L0-0na/Motor_Drive/figures/4 lec.jpg

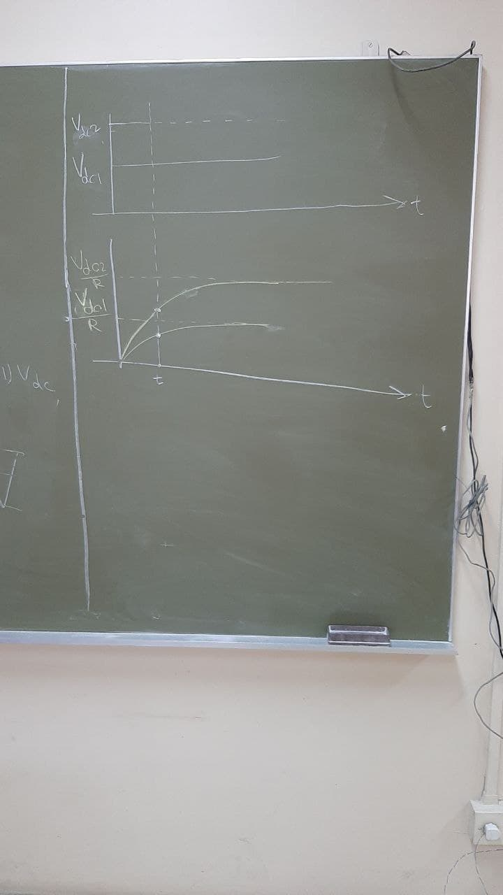
figures/4 lec.jpg
