L0-0na/Motor_Drive/figures/6 lec.jpg

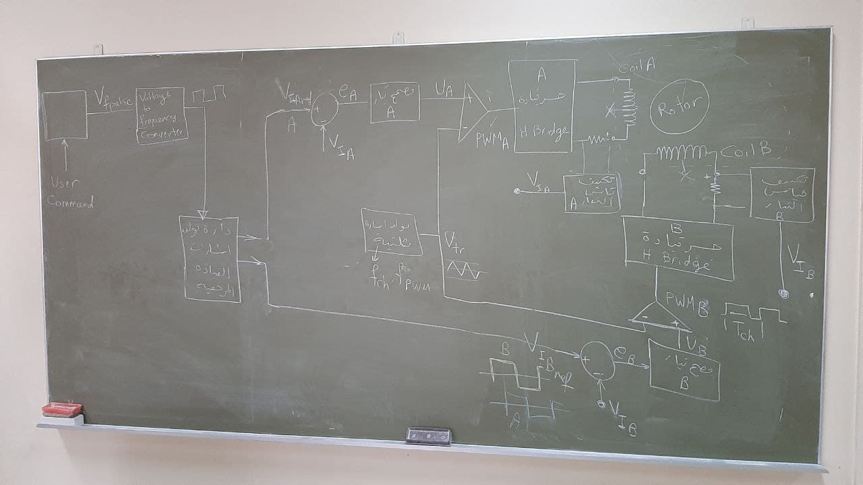
figures/6 lec.jpg
