L0-0na/Motor_Drive/report final.pdf

# اجلمهورية العربية السورية املعهد العايل للعلوم التطبيقية والتكنولوجيا

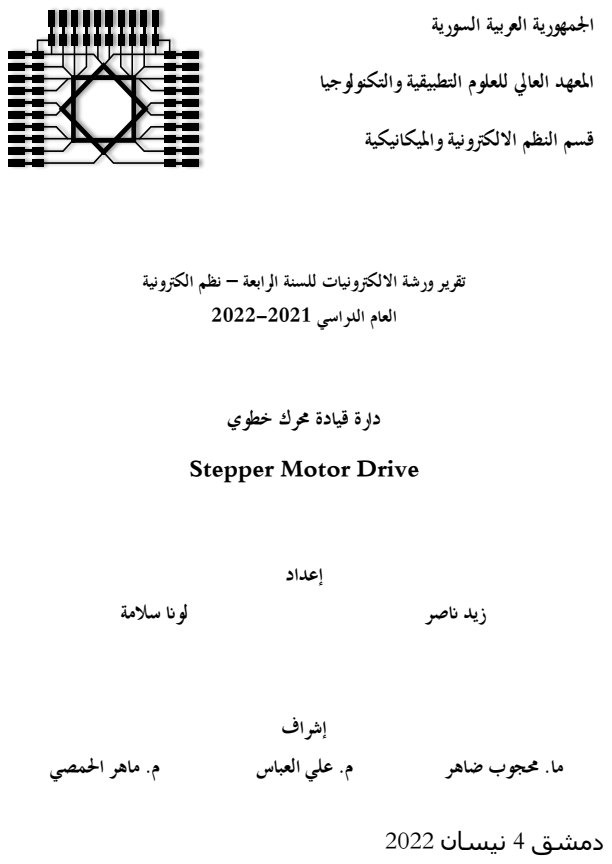
[picture p3: page 1]
إعداد; إشراف; دمشق 4 نيسان 2022

قسم النظم االلكرتونية وامليكانيكية

تقرير ورشة االلكرتونيات للسنة الرابعة – نظم الكرتونية
العام الدراسي 2022-2021

دارة قيادة حمرك خطوي
Stepper Motor Drive

زيد انصر لوان سالمة

ما. حمجوب ضاهر م. علي العباس م. ماهر احلمصي

### المحتويات

ملخص6 |
.1 المحرك الخطوي (Motor Stepper (7 |
.1.1 مكونات المحرك الخطوي7 |
.1.2 أنواع المحرك الخطوي 7 |
.2 طرائق قيادة المحركات الخطوية9 |
.2.1 أحادية القطبية (control Unipolar (9 |
2.1.1. آلية التحكم9 |
.2.1.2 تحليل دارة التحكم11 |
.2.2 ثنائي القطبية control Bipolar15 |
.2.2.1 آلية التحكم15 |
.2.2.2 تحليل الدارة16 |
.3 دفتر الشروط21 |
.4 المخطط الصندوقي 21 |
.5 أجزاء دارة القيادة22 |
.5.1 التغذية السالبة والموجبة22 |
.5.1.1 التغذية السالبة22 |
مضخم pull-push من الصنف AB: 25 |
دارة استعادة DC25 |
دارة مالحقة قمم سالبة26 |
.5.1.2 التغذية الموجبة27 |
.5.2 توليد إشارة القيادة28 |
5.2.1. توليد إشارتي دخل بفرق صفحة 90 )Shifter Phase)28 |
.5.2.2 تعديل مطال إشارة القيادة29 |
.5.2.3 التحكم بجهة الدوران 30 |
32 | Voltage to frequency circuit .5.3
.5.3.1 تحليل الدارة32 |
5.3.2. تعديل عرض ومطال خرج دارة VTF34 |
.5.3.3 تصميم عناصر دارة frequency to Voltage35 |
.5.4 مولد اإلشارة المثلثية )Generator Form Wave)37 |
مبدأ عمل الدارة: 37 |
.5.4.1 تحليل الدارة37 | :
.5.4.2 تصميم الدارة38 |

5.5. توليد إشارات PWM 39 |
.6 تصحيح التيار40 |
6.1. نموذج المحرك: 40 |
6.2. حلقة التحكم41 |
6.2.1. ربح جسر القيادة 41 |
6.2.2. تصميم قائس تيار )Measurements Current)43 |
.6.3 تصميم المصحح PI 46 |
6.3.1. دارة المصحح 46 |
6.3.2. تصميم عناصر دارة المصحح47 |
.7 التطبيق العملي 51 |
.7.1 دارة التغذية السالبة والموجبة51 |
7.2. دارة اإلشارة المثلثية51 |
52 | voltage to frequency | دارة | 7.3.
7.4. إشارتي القيادة المرجعيتين المترابعتين53 |
7.5. الحلقة المفتوحة53 |
.7.6 الحلقة المغلقة: 55 |
الخاتمة56 |
مراجع 57 |

Figure 1 المحرك الخطوي ذو المغناطيس الدائم 7 |
Figure 2 المحرك الخطوي ذو المقاومة المغناطيسية المتغيرة 8 |
Figure 3 المحرك الخطوي الهجين8 |
Figure 4 القيادة بطريقة أحادية القطبية9 |
Figure 5 توضع األقطاب بحالة تفعيل إشارة التحكم 1A9 |
Figure 6 توضع األقطاب بحالة تفعيل إشارة التحكم 1B10 |
Figure 7 توضع األقطاب بحالة تفعيل إشارة التحكم 2A10 |
Figure 8 توضع األقطاب بحالة تفعيل إشارة التحكم 2B11 |
Figure 9 نمذجة دارة التحكم لنصف وشيعة 11 |
Figure 10 نموذج الدارة بحالة تفعيل إشارة التحكم12 |
Figure 11 نموذج الدارة بحالة إلغاء تفعيل إشارة التحكم12 |
Figure 12 التيار المار في الوشيعة14 |
Figure 13 تيار الترانزستور)األحمر(، تيار الديود)األزرق(14 |
Figure 14 القيادة بطريقة ثنائي القطبية 15 |
Figure 15 تسلسل إشارات التحكم16 |
Figure 16 نمذجة دارة التحكم لنصف الوشيعة16 |
Figure 17 نمذجة المرحلة األولى 17 |
18 Figure نمذجة المرحلة الثانية17 |
Figure 19 نمذجة المرحلة الثالثة18 |
Figure 20 نمذجة المرحلة الرابعة19 |
Figure 21 التيار المار في الوشيعة19 |
Figure 22 تيار الديود 3D2,D( األزرق(، تيار الترانزستور9Q8,Q( األخضر(، تيار الديود 4D1,D( األصفر(، تيار
الترانزستور7Q10,Q( األحمر(20 |
Figure 23 الجهد المطبق بين طرفي الوشيعة20 |
Figure 24 المخطط الصندوقي للتغذية السالبة22 |
Figure 25 نمذجة دارة التغذية السالبة 22 |
Figure 26 دارة 555 كقادح مهتز 23 |
Figure 27 جزء شحن وتفريغ المكثفةC 24 |
25 | Push Pull | مضخم | 28 Figure
Figure 29 دارة استعادة DC 25 |
Figure 30 دارة مالحقة قمم 26 |
Figure 31 خرج دارة التغذية السالبة 27 |
32 Figure دارة المنظم 27 |
Figure 33 دارة توليد فرق الطور28 |
34 Figure إشارة الساعة29 |
Figure 35 خرج القالبين29 |
Figure 36 دارة تعديل مطال اإلشارة المرجعية 29 |
Figure 37 نمذجة الجسر مع القالبين ومفتاح تغيير الجهة31 |
Figure 38 اإلشارتين المترابعتين31 |
32 | voltage to frequency | دارة | 39 Figure
34 | voltage to frequency | دارة | خرج | 40 Figure
35 | | التعديل | بعد Voltage to frequency | دارة | 41 Figure

Figure 42 دارة توليد إشارة مثلثية37 |
Figure 43 خرج دارة مولد اإلشارة المثلثية 38 |
Figure 44 مولد إشارة PWM39 |
Figure 45 نموذج المحرك الخطوي 40 |
Figure 46 حلقة التحكم بالتيار 41 |
47 Figure المخطط الصندوقي لPWM41 |
Figure 48 اإلشارة المثلثية واإلشارة المرجعية 42 |
Figure 49 وصل دارة قائس التيار مع الحمل 43 |
Figure 50 دارة قائس التيار 44 |
Figure 51 دارة القائس بعد إضافة الBuffers45 |
Figure 52 تطبيق دارة القائس لقياس تيار الجسر 45 |
Figure 53 دارة المصحح 46 |
Figure 54استجابة النظام بعد التصحيح لدخل خظوي 48 |
Figure 55 مخطط بود للنظام بعد التصحيح 48 |
Figure 56 خرج المصحح )األزرق(, إشارة الدخل )األصفر(, خرج النظام )األحمر( 49 |
Figure 57 خرج المصحح )األزرق(, إشارة الدخل )األصفر(, خرج النظام )األحمر( 49 |
Figure 58 استجابة التيار 50 |
Figure 59 خرج المصحح (command (50 |
Figure 60 إشارتي التغذية السالبة والموجبة51 |
Figure 61 اإلشارة المثلثية51 |
52 | voltage to frequencyال | إشارة | 62 Figure
Figure 63 منحني جهد الدخل بداللة تردد الخرج 52 |
Figure 64 إشارتي القيادة53 |
Figure 65 إشارتي القيادة المحملتان بنبضات PWM53 |
Figure 66 استجابة التيار من أجل تردد 32.4 HZ 54 |
Figure 67 استجابة التيار من أجل تردد 85 HZ54 |

### ملخص

خالل هذا المشروع تم تصميم وتنفيذ دارة قيادة لمحرك خطوي هجين ثنائي الطور Motor Stepper Hybrid من نوع 801BYGH42 لتدوير المحرك بسرعات مختلفة تصل إلى RPM .300 تضمن تصميم الدارة دراسة تقنيات القيادة الخاصة بالمحركات الخطوية واختيار الطريقة األمثل لقيادة المحرك. بداية ً تم قيادة المحرك بالحلقة المفتوحة بتوليد إشارات مرجعية ومقارنتها مع إشارة مثلثية لتعطي نبضات PWM التي تفعل جسر القيادة لنحصل على دوران مستمر للمحرك. ثم تم التحكم باستجابة التيار باستخدام مصحح PI بالحلقة المغلقة لتحقيق دوران مستمر للمحرك من أجل سرعات عالية.

## .1 المحرك الخطوي (Motor Stepper(

المحرك الخطوي هو نظام كهروميكانيكي يقوم بتحويل الطاقة الكهربائية إلى طاقة ميكانيكية عن طريق تدوير محور المحرك. يتميز المحرك الخطوي عن باقي المحركات بأن دورته مقسمة إلى خطوات ويمكن للمحرك أن يستقر على أي خطوة بدون تغذية راجعة في حال استخدامه في التطبيق المناسب )يمكن أن يكون العزم الذي يقدمه المحرك ال يكفي لتدوير المحور وبالتالي يتم احتساب الخطوات ولكن في الحقيقة المحرك ال يدور(.

1 .1. مكونات المحرك الخطوي يوجد عدة أنواع للمحرك الخطوي لكن تشترك جميعها في هذه األجزاء:

-1 الدائر )Rotor): هو الجزء الذي يدور من المحرك وعليه يُثبت محور المحرك الذي يحمل األحمال الميكانيكية. -2 الثابت )Stator): هو الجزء الثابت من المحرك ويحتوي الوشائع واألسالك التي يتم تغذية المحرك من خاللها. عدد الوشائع المستخدمة في الثابت يتبع لنوع التطبيق )أحادي الطور, ثنائي الطور, ثالثي الطور(.

2 .1. أنواع المحرك الخطوي
تصنف المحركات الخطوية من ناحية طريقة التصنيع إلى ثالث مكونات أساسية:

-1 المحرك الخطوي ذو المغناطيس الدائم )Magnet Permanent The(: في هذذا النوع من المحركذات يكون الذدائر عبذارة عن مغنذاطيس دائم بينمذا يتكون الثذابذت من مذادة فيرو مغنذاطي سذيذة تتوضذع ضذمنها نواقل. ينتا الدوران عن طريق تفاعل الحقل المغناطيسذي الدائم للدائر مع الحقل المغناطيسذي المتولد من تغذية نواقل الثابت.
يتميز هذا النوع من المحركات بعزم دوران كبير مقارنة بالمحركات ذو المقاومة المغناطيسية المتغيرة ولكن هذا النوع من المحركات محدود من حيث عدد الخطوات الممكنة في الدورة.

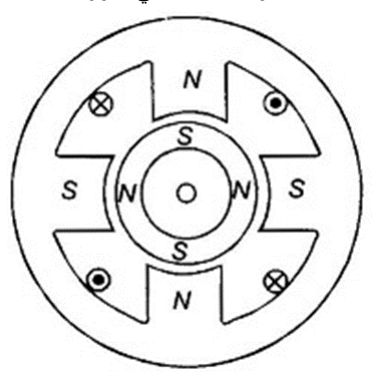
[picture p4: figure]

Figure 1 المحرك الخطوي ذو المغناطيس الدائم

-2 المحرك الخطوي ذو المقاومة المغناطيسية المتغيرة )Reluctance Variable The(: يتكون الدائر من مادة فيرو مغناطيسية مصممة على شكل أسنان. يتكون الثابت من مادة فيرو مغناطيسية أيضاً مصممة على شكل أسنان على السطح الداخلي ويتم لف الوشائع حول أسنان الثابت. ينتا دوران المحرك من توضع الدائر بحيث تكون المقاومة المغناطيسية لتدفق حقل الثابت المغناطيسي عبره أقل ما يمكن بالتالي بتفعيل وشائع الثابت بتسلسل معين نحصل على دوران مستمر.

يتميز هذا النوع من المحركات بخطوة صغيرة ودقيقة لكن عزم الدوران صغير مقارنة بباقي األنواع لكونه يعتمد على حقل مغناطيسي وحيد )حقل الثابت(.

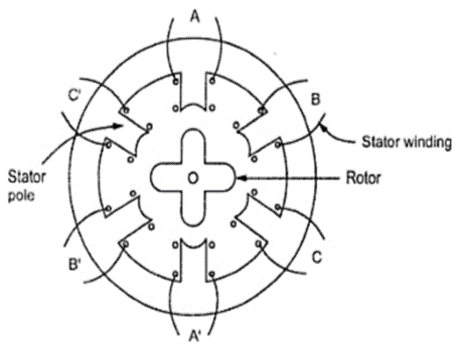
[picture p5: figure]

Figure 2 المحرك الخطوي ذو المقاومة المغناطيسية المتغيرة

-3 المحرك الخطوي الهجين (Hybrid The(: هذا النوع من المحركات يعتمد على مبدأ عمل كل من المحركات ذو المغناطيس الدائم والمحركات ذو المقاومة المغناطيسية المتغيرة للحصول على عزم كبير باإلضافة لخطوة صغيرة ودقيقة. في هذا النوع من المحركات يكون الدائر عبارة عن مغناطيس دائم أسطواني يتوضع ضمن أسطوانة مسننة. يتكون الثابت من مادة فيرو مغناطيسية أيضاً مصممة على شكل أسنان على السطح الداخلي. عند تغذية وشائع الثابت ينتا أقطاب مغناطيسية وكون الثابت عبارة عن مغناطيس دائم بالتالي تتوضع كل من أسنان الثابت والدائر بحيث تحقق أقل مقاومة مغناطيسية بين األقطاب المتعاكسة وأكبر مقاومة مغناطيسية بين األقطاب المتشابهة.

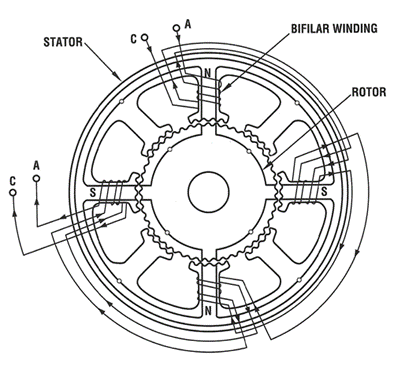
[picture p6: figure]

Figure 3 المحرك الخطوي الهجين

كما يتم تصنيف المحركات الخطوية تبعاً لكيفية إتاحة أطراف النواقل للمستخدم إلى:

-1 ثنائية القطبية (Bipolar(: يُتاح للمستخدم طرفي كل ناقل. -2 أحادي القطبية (Unipolar(: يتاح للمستخدم طرفي كل ناقل باإلضافة لنقطة الوسط.

### .2 طرائق قيادة المحركات الخطوية

المحرك الذي تم استخدامه في دراستنا من نوع Moto Stepper Hybrid Unipolar ثنائي الطور بالتالي يمكن التحكم به إما كأحادي قطبية أو كثنائي قطبية.

1 .2. أحادية القطبية (control Unipolar( 1 1. .2. آلية التحكم

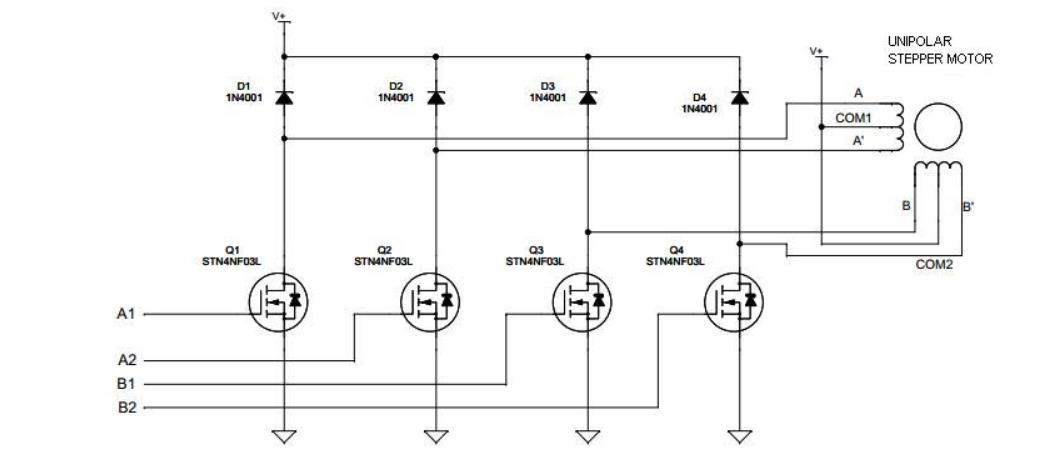
[picture p7: figure]

Figure 4 القيادة بطريقة أحادية القطبية

′ | يتم وصل نقطة المنتصف لكل من الوشيعتين إلى + ووصل النقاط ,
′ , , إلى األرضي مع قواطع هي
الترانزستورات 4 3,2,1, على الترتيب. وتم إضافة كل من الديودات 43, 2,1, كدوالب حر في حال تم فتح القاطعة ولم ينعدم تيار الوشيعة بعد.

لنفترض أنه في البداية تم تفعيل إشارة التحكم 1 عندها سيمر التيار من 1COM إلى مولداً حقال مغناطيسياً كما في الشكل:

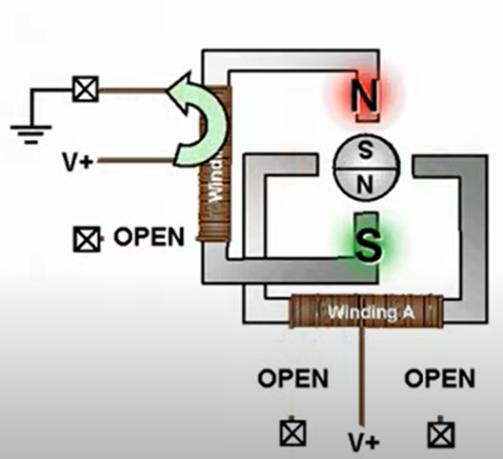
[picture p8: figure]

Figure 5 توضع األقطاب بحالة تفعيل إشارة التحكم 1A

نتيجة لهذا الحقل يدور الدائر لوضع االستقرار الذي يفرضه حقل الثابت.

ثم يتم إلغاء تفعيل إشارة التحكم 1 وتفعيل إِشارة التحكم 1 عندها يمر التيار من 2COM إلى مولداً حقال مغناطيسياً كما في الشكل:

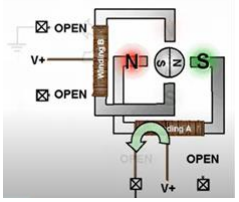
[picture p9: figure]

Figure 6 توضع األقطاب بحالة تفعيل إشارة التحكم 1B

| نتيجة للحقل الجديد للثابت يدور الدائر 90
عكس عقارب الساعة.

بنفس الطريقة يتم إلغاء تفعيل إشارة التحكم 1 وتفعيل إشارة التحكم 2 ليتولد حقل مغناطيسي ناتا عن مرور
| التيار من 1COM إلى ′ مسبباً دوران المحرك 90
أخرى عكس عقارب الساعة.

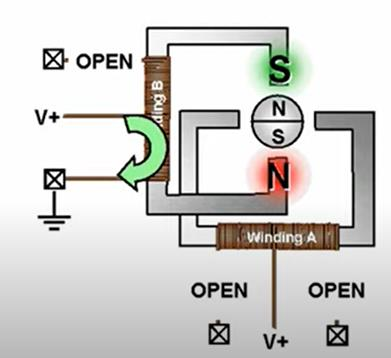
[picture p10: figure]

Figure 7 توضع األقطاب بحالة تفعيل إشارة التحكم 2A

أخيراً بإلغاء تفعيل إِشارة التحكم 2 وتفعيل إِشارة التحكم 2 ليتولد حقل مغناطيسي ناتا عن مرور التيار من
| 2COM إلى ′ مسبباً دوران المحرك 90
أخرى عكس عقارب الساعة.

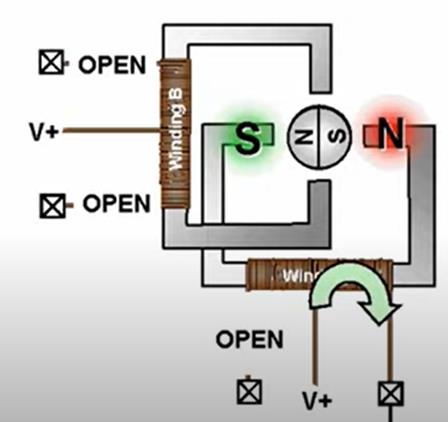
[picture p11: figure]

Figure 8 توضع األقطاب بحالة تفعيل إشارة التحكم 2B

بالتالي بترتيب تفعيل إشارات التحكم بالشكل الصحيح نضمن دوران مستمر للمحرك حيث يتم عند كل تغيير إلشارة التحكم تغيير الحقل المغناطيسي للثابت ويقوم الدائر بمالحقته وبذلك نحصل على دوران المحرك.

لتغيير جهة دوران المحرك علينا فقط أن نقوم بتغيير تسلسل إشارات التحكم:

دوران عكس عقارب الساعة ... 1, 2, 2, 1, 1,

دوران مع عقارب الساعة ... 1, 1, 2, 2, 1,

ليس من الضروري أن نبدأ دائما من 1 حيث نستطيع أن نبدأ من أي إشارة تحكم ضمن السلسلة بشرط أن نكمل السلسلة بدءاً من اإلشارة المختارة مثالً كل من السالسل التالية تؤمن دوران مع عقارب الساعة:

B1, A2, B2, A1, B1, …

A2, B2, A1, B1, A2, …

B2, A1, B1, A2, B2, …

2 1. .2. تحليل دارة التحكم

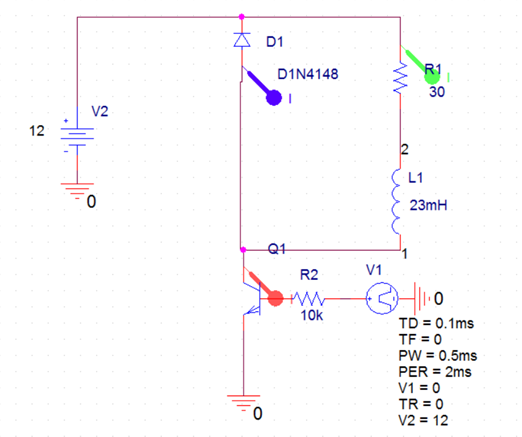
[picture p12: figure]

Figure 9 نمذجة دارة التحكم لنصف وشيعة

تم العمل على محرك مقاومة ملفات الثابت له Ω 30 = 1 Rوذاتية ملفاته mH 23 = 1L. وتم نمذجة إشارة التحكم بمولد نبضات مربعة.

خالل فترة تطبيق إشارة تحكم يكون الترانزستور الموافق لإلِشارة المفعلة في النمط ON والديود الموافق لهذه اإلشارة في النمط OFF بالتالي تكون الدارة المكافئة:

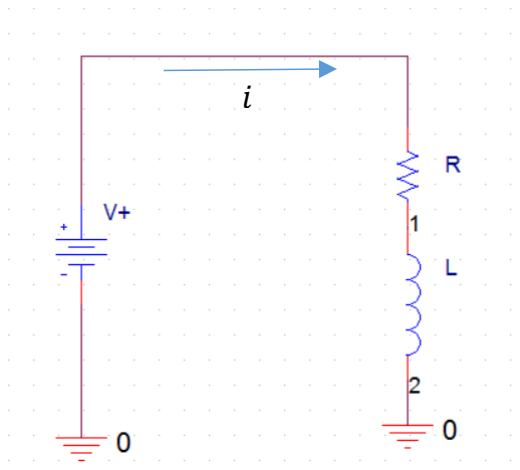
[picture p13: figure]

Figure 10 نموذج الدارة بحالة تفعيل إشارة التحكم

V+ = R. i + L

di
dt , i(0) = i0

⇒ i(t) =

V+
R

(1 − exp (−

R
L
| .t)) + i0 exp (−

R
L

.t)

| يستمر تطبيق إِشارة التحكم لفترة زمنية
4

i (

T
4

) =

V+
R

(1 − exp (−

R
L

T
4

)) + i0 exp (−

R
L

T
4

)

بعد االنتهاء زمن تفعيل إِشارة التحكم يصبح الترانزستور الموافق لإلِشارة المفعلة في النمط OFF والديود الموافق لهذه اإلشارة في النمط ON بالتالي تكون الدارة المكافئة:

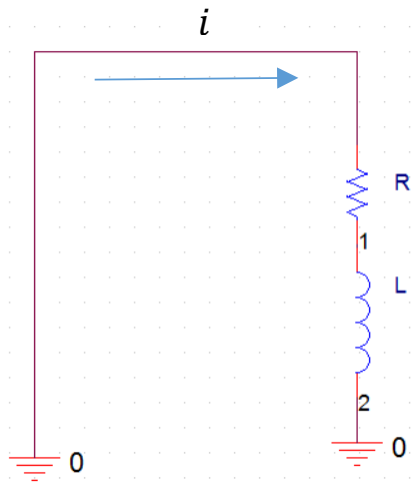
[picture p14: figure]

Figure 11 نموذج الدارة بحالة إلغاء تفعيل إشارة التحكم

0 = R. i + L

di
dt
ومن استمرارية التيار المار في الوشيعة:

i (

T
4

) =

V+
R

(1 − exp (−

R
L

T
4

)) + i0 exp (−

R
L

T
4

)

بالتالي:

i(t) = (

V+
R

(1 − exp (−

R
L

T
4

)) + i0 exp (−

R
L

T
4

)) exp (−
R
L

. (t −

T
4

))

يبقى الديود في الوضع ON حتى ينعدم تياره عند اللحظة وعندها يعود الترانزستور للوضع ON حيث تم تطبيق إِشارة التحكم من جديد.

ومن استمرارية التيار المار في الوشيعة:

i(T) = i0
(

V+
R

(1 − exp (−

R
L

T
4

)) + i0 exp (−

R
L

T
4

)) exp (−

R
L

3T
4

) = i0

i0 =

V+
R

1 − exp (−

RT
4L

)

exp (

3RT
4L

) − exp (−

RT
4L

)

بالتالي تصبح معادلة التيار المار في الوشيعة:

i(t) =

V+
R

(1 − exp (−
R
L

.t)

exp (

3RT
4L

) − 1

exp (

3RT
4L

) − exp (−

RT
4L

)

) ,t <
T
4

i(t) =

V+
R

(
exp (

RT
L

) − exp (−

3RT
4L

)

exp (

RT
L

) − 1

)exp (−
R
L

. (t −

T
4

)) ,
T
4

< t < T

التطبيق العددي: m 2 = , m 23 = , Ω 30 R = , volt12 = +V

i0 | imax
| | m 206.87 m 29.2 نظرياً
| | m 209.99 m 10 المحاكاة

يعود الفرق بين قيم المحاكاة والقيم النظرية إلهمال هبوط الجهد على كل من الديود والترانزستور خالل الدراسة النظرية.

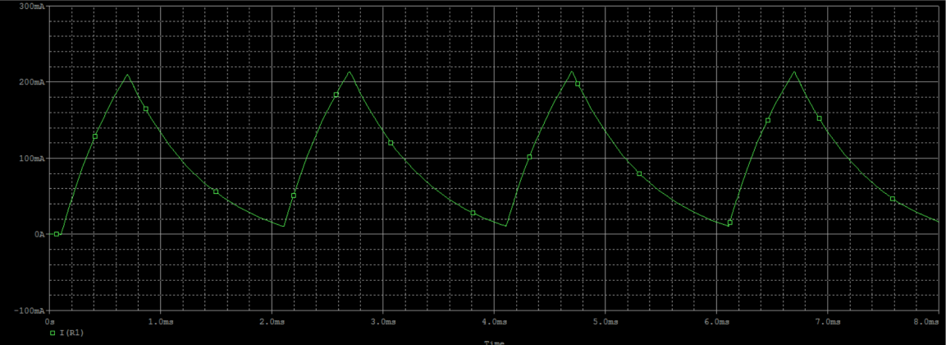
[picture p15: figure]

Figure 12 التيار المار في الوشيعة

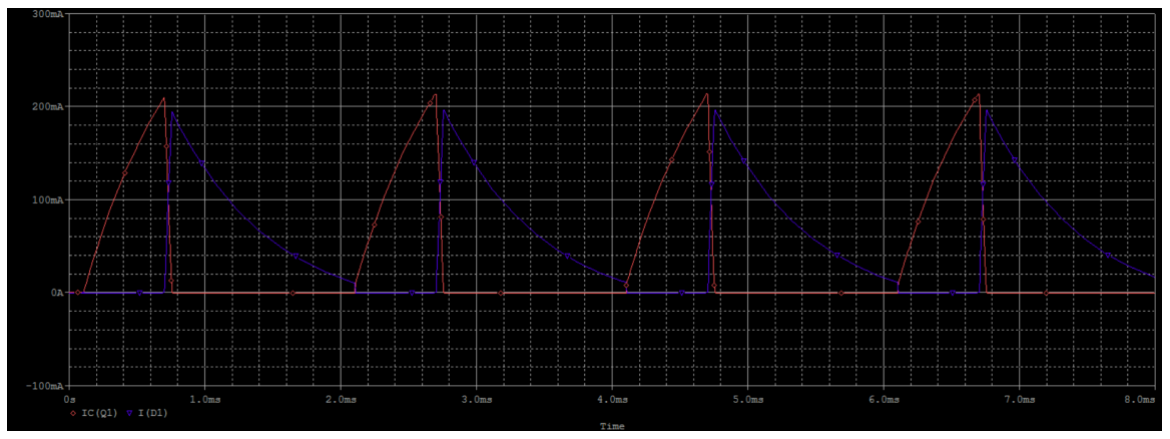
[picture p16: figure]

Figure 13 تيار الترانزستور)األحمر(، تيار الديود)األزرق(

- مساوئ هذه الطريقة:
ال يتم استخدام كل اإلمكانيات المتاحة )فقط نصف ملف يعمل خالل لحظة معينة( أي يتم استهالك ربع كمية النحاس المستخدمة للف الوشائع.

2 .2. ثنائي القطبية control Bipolar في هذا النوع من التحكم ال يتم استخدام نقطة الوسط بالتالي ال يوجد طريقة مباشرة لعكس جهة التيار المار في الوشائع لذلك يتم استخدام جسر H كمفعل للمحرك وهذا ما يمكننا من عكس جهة التيار.

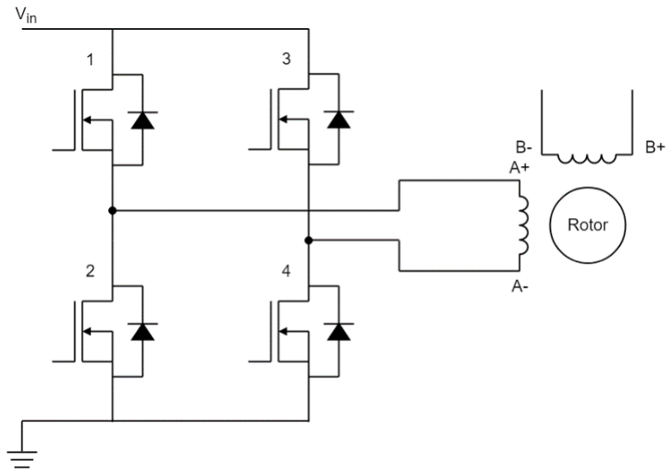
[picture p17: figure]

Figure 14 القيادة بطريقة ثنائي القطبية
1 2. .2. آلية التحكم
يوجد عدة طرق لقيادة المحرك باستخدام جسر H منها

-1 طور واحد فقط يعمل في كل لحظة: أوالً يتم تفعيل إشارات التحكم 1 و4 للوشيعة ثم يتم تفعيل إِشارات التحكم 1 و4 للوشيعة وإلغاء تفعيل إشارات التحكم السابقة. يليها تفعيل إشارات التحكم 3 و2 للوشيعة وإلغاء تفعيل إشارات التحكم السابقة. ثم تفعيل إشارات التحكم 3 و2 للوشيعة وإلغاء تفعيل إشارات التحكم السابقة. ال تعطي هذه الطريقة عزم كبير ألنه يتم تفعيل وشيعة واحدة في كل نصف دور.

-2 طوران يعمالن في كل لحظة: أوالً يتم تفعيل إِشارات التحكم 1 و4 لكل من و معاً عندها يتشكل حقل مغناطيسي ناتا عن مجموع كل من الحقلين الناتجين عن الوشيعة والوشيعة ويدور الدائر إلى موضع التوازن الذي يحدده الحقل المغناطيسي الناتا من الثابت. يتم بعدها تفعيل إشارات التحكم 3 و2 للوشيعة وإلغاء 1و4 بنفس الوقت نبقي على إشارات التحكم السابقة للوشيعة فيدور إلى موضع التوازن الجديد. ثالثاً يتم تفعيل إشارات التحكم 3 و2 للوشيعة ونبقي على إشارات التحكم السابقة للوشيعة . أخيراً يتم تفعيل إشارات التحكم 1 و4 للوشيعة ونبقي على إشارات التحكم السابقة للوشيعة .

بالتالي نستطيع قيادة المحرك بتطبيق إشارتي التحكم , ، عندما تكون بالمستوى المرتفع يتم تفعيل الترانزستورين 1و4 للجسر األول وعندما تكون بالمستوى المنخفض يتم تفعيل الترانزستورين 2و،3 كذلك األمر بالنسبة لإلشارة والجسر الثاني.

لتحقيق ما سبق يجب أن تكون إشارة التحكم على ترابع مع .

نحصل في هذه الطريقة على عزم أكبر من الطريقة السابقة ونفس عدد الخطوات.

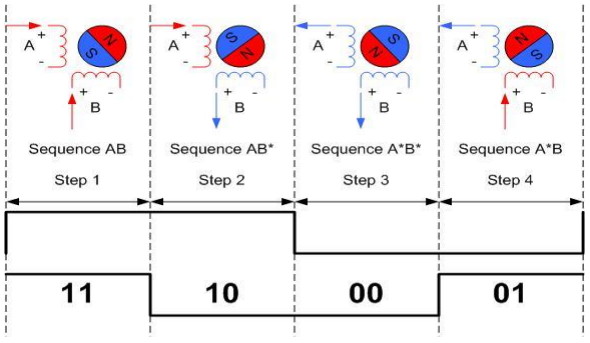
[picture p18: figure]

Figure 15 تسلسل إشارات التحكم

سيتم استخدام طريقة ثنائية القطبية بما أنها تؤمن عزم أكبر بنفس عدد الخطوات.

2 2. .2. تحليل الدارة

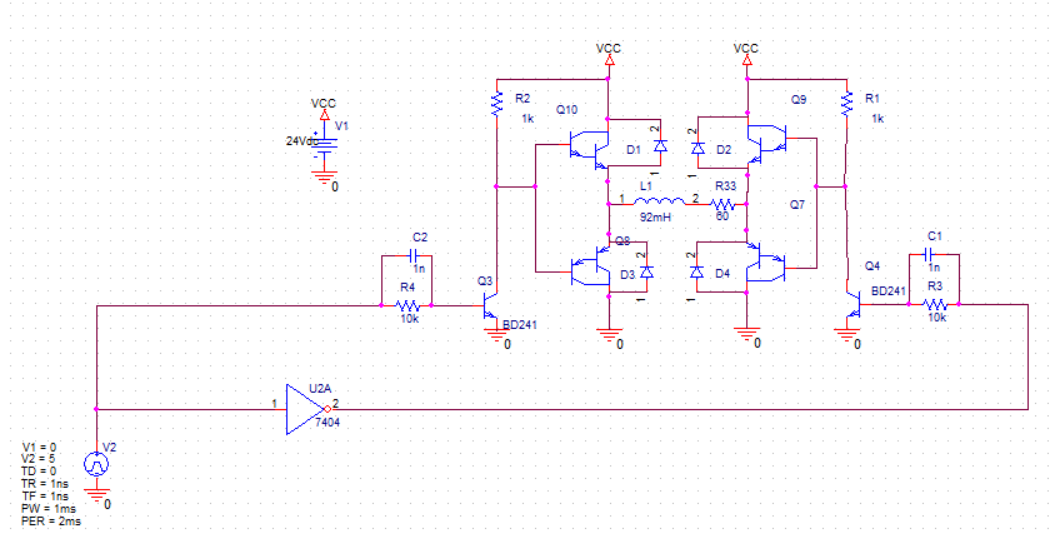
[picture p19: figure]

يعمل الترانزستورين 43, مع المقاومتين 3 4, على رفع مطال إشارة التحكم من volt 5 إلى volt 24 فعند تطبيق إشارة التحكم volt 5 على قاعدة الترانزستور 3 يصبح في النمط ON وبالتالي يصبح جهد قاعدة كل من الترانزستورين 8 10, volt 0 وعند تطبيق إشارة التحكم volt 0 على قاعدة الترانزستور 3 يصبح في النمط OFF وبالتالي يصبح جهد قاعدة كل من الترانزستورين 8 10, volt 24 تقريبا.ً وكذلك األمر بالنسبة لكل من الترانزستورين 79,.

يتم اختيار 3 4, بحيث يكون التيار المسحوب من المنبع عبرهما كافياً إلدخال الترانزستورين 43, باإلشباع.

Figure 16 نمذجة دارة التحكم لوشيعة

تم استخدام المكثفتين 2 1, لتأمين إغالق سريع للترانزستورين 43, وبدوره فتح وإغالق سريع للترانزستورات 10 9,8,7,.

أما بالنسبة الختيار تشكيلة دارلنغتون للترانزستورات 10 9,8,7, فذلك لتأمين مرتفعة وبالتالي تيار قاعدة منخفض بحكم أن تيار المجمع يتم تحديده من قبل الحمل. وكلما كان تيار القاعدة منخفض أكثر يكون جهد القاعدة أقرب إلى القيمة المطلوبة والتي هي volt .24

مراحل عمل الدارة
المرحلة األولى: عندما تكون الديودات 41, في النمط ON:

Figure 17 نمذجة المرحلة األولى

−VCC = L

di
dt + Ri , i(0) = i0

i(t) =

−VCC
R

(1 − exp (−

R
L

.t)) + i0 exp (−

R
L

.t)

يبقى الديودان 41, في النمط ON حتى ينعدم التيار عند اللحظة 1:

i(t1

) = 0 =

−VCC
R

(1 − exp (−

R
L

.t1)) + i0 exp (−

R
L

.t1)

t1 =

L
R

ln(

Ri0 + VCC

VCC

)

المرحلة الثانية: عندما يكون 7 10, في النمط ON والديودات 41, في النمط OFF:

نمذجة المرحلة الثانية18 Figure

VCC = L

di
dt + Ri , i(t1

) = 0

i

i

i(t) =

VCC
R

(1 − exp (−

R
L

. (t − t1)))

تستمر هذه المرحلة من اللحظة 1 حتى اللحظة α:

i(αT) =

VCC
R

(1 − exp (−

R
L

. (αT − t1)))

المرحلة الثالثة: عندما تكون الديودات 32, في النمط ON:

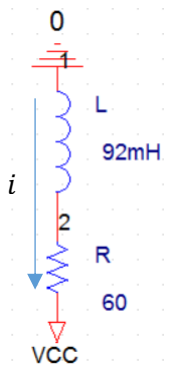
[picture p20: figure]

Figure 19 نمذجة المرحلة الثالثة

−VCC = L

di
dt + Ri , i(αT) =

VCC
R

(1 − exp (−

R
L

. (αT − t1

)))

i(t) =

−VCC
R

(1 − exp (−

R
L

. (t − αT))) + i(αT) exp (−

R
L

. (t − αT))

يبقى الديودان 32, في النمط ON حتى ينعدم التيار عند اللحظة 2:

i(t2

) = 0 =

−VCC
R

(1 − exp (−

R
L

. (t2 − αT))) + i(αT) exp (−

R
L

. (t − αT))

t2 =

L
R

ln(

Ri(αT) + VCC

VCC

) + αT

المرحلة الرابعة: عندما يكون 89, في النمط ON والديودات 32, في النمط OFF:

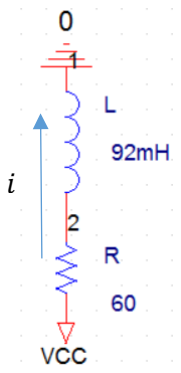
[picture p21: figure]

Figure 20 نمذجة المرحلة الرابعة

VCC = L

di
dt + Ri , i(t2

) = 0

i(t) =

VCC
R

(1 − exp (−

R
L

. (t − t2)))

تستمر هذه المرحلة من اللحظة 2 حتى اللحظة :

i(T) =

VCC
R

(1 − exp (−

R
L

. (T − t2)))

من استمرار تيار الوشيعة نحصل على قيمة 0:

i0 = i(T)

التطبيق العددي: 0.5 = ,m 2 = , m 92 = , Ω 60 R = , volt24 = +V

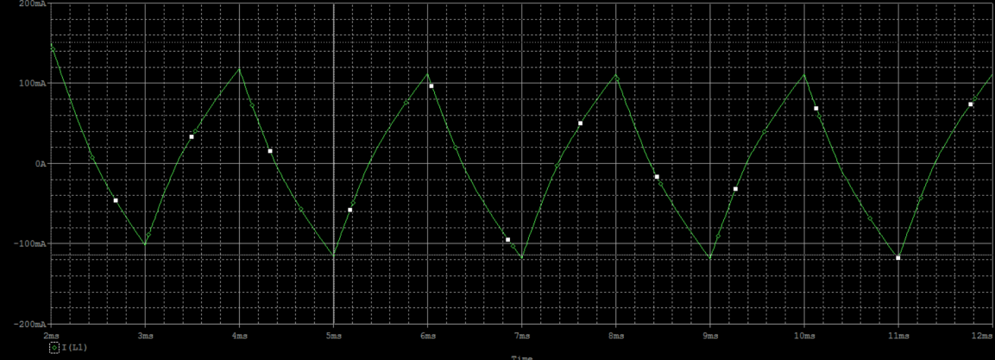
[picture p22: figure]

Figure 21 التيار المار في الوشيعة

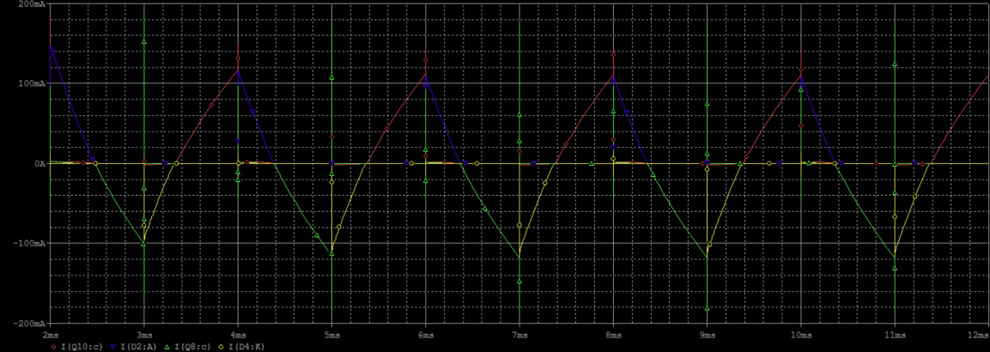
[picture p23: figure]

Figure 22 تيار الديود 3D2,D( األزرق(، تيار الترانزستور9Q8,Q( األخضر(، تيار الديود 4D1,D( األصفر(، تيار الترانزستور7Q10,Q( األحمر(

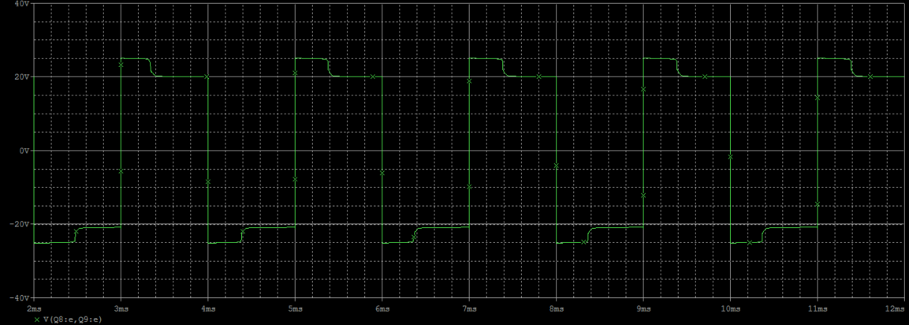
[picture p24: figure]

Figure 23 الجهد المطبق بين طرفي الوشيعة

نالحظ أن مطال إشارة التيار في التحكم ثنائي القطبية تقريباً تساوي مطال إشارة التيار في التحكم أحادي القطبية لكن في التحكم ثنائي القطبية يمر هذا التيار في كل الوشيعة مما يعطي حقالً مغناطيسياً أكبر. لذلك سنعتمد التحكم ثنائي القطبية لقيادة المحرك.

### .3 دفتر الشروط

نرغب بالتحكم بسرعة واتجاه دوران محرك خطوي(Motor Stepper Hybrid Unipolar (نوع )801BYGH42 )بحيث تكون سرعته العظمى RPM ،300 باستعمال وحدة تغذية وحيدة لتغذية جميع أجزاء دارة القيادة.

### .4 المخطط الصندوقي

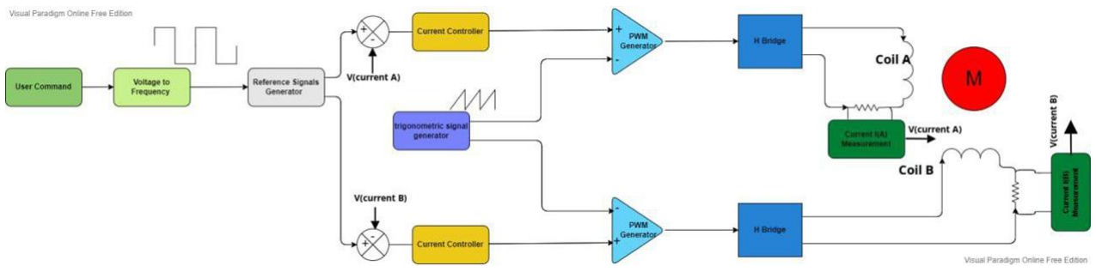
[picture p25: figure]

يتم تحديد سرعة واتجاه الدوران عن طريق command User بحيث يحدد المستخدم جهد DC متناسب طرداً مع السرعة التي يريدها من ثم يتم توليد إشارة مربعة ترددها متوافق مع هذا الجهد عن طريق To Voltage Converter Frequency. تساهم اإلشارة المربعة بتوليد إشاراتي القيادة المرجعية المترابعتين. ويتم طرحهما من خرج قائسي التيار لتوليد إشارتي الخطأ. تدخل إشارة الخطأ إلى مصحح التيار الذي يعطي أمر التحكم)command). يحدد أمر التحكم عرض النبضة )PWM )التي تقود جسرH عن طريق المقارنة مع إشارة مثلثية ترددها أكبر بكثير من تردد إشاراتي القيادة المرجعية. وأخيراً يعمل جسر H كمفعل للمحرك الخطوي بحيث يدوّر المحرك بالسرعة المطلوبة.

### .5 أجزاء دارة القيادة

1 .5. التغذية السالبة والموجبة 1 1. .5. التغذية السالبة
بما أنه من متطلبات دفتر الشروط االعتماد على وحدة تغذية وحيدة والتي تحوي على منبعي جهد متغيرين فنحن بحاجة إلى دارة تؤمن التغذية السالبة لمضخمات العمليات المستخدمة كون أحد منابع الجهد مستخدم لتأمين جهد التغذية لجسر H.

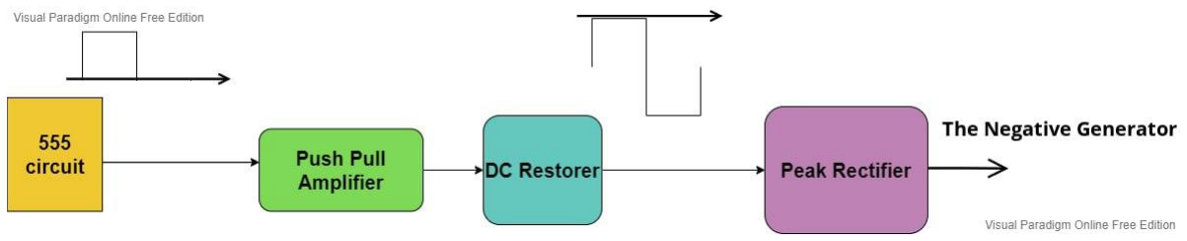
[picture p26: figure]

Figure 24 المخطط الصندوقي للتغذية السالبة

لتوليد تغذية سالبة تم استخدام مؤقت 555 لتوليد إشارة مربعة مطالها ) volt 0,5 )متبوعة بمضخم نوع ) push pull )وذلك لتأمين سحب التيار المطلوب من قبل الحمل ثم استخدام دارة استعادة DC لجعل مطالها )volt 0,-5). وأخيراً دارة مالحقة قمم للحصول على إشارة DC سالبة.

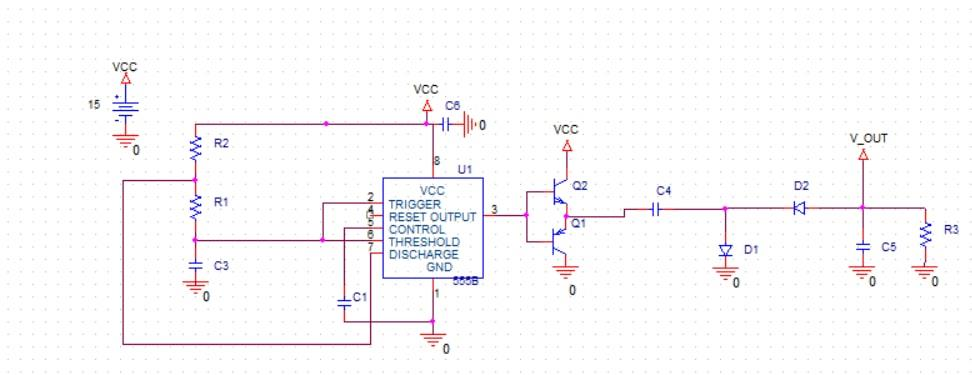
[picture p27: figure]

Figure 25 نمذجة دارة التغذية السالبة

1 . 1 . 1 . .5 مكونات دارة توليد التغذية السالبة: قادح مهتز )Multivibrator Astable ) يتم استخدام دارة 555 لتشكيل قادح مهتز حيث يعطي خرج دارة 555 إشارة مربعة بتردد يتبع لقيم العناصر .R1, R2, C3

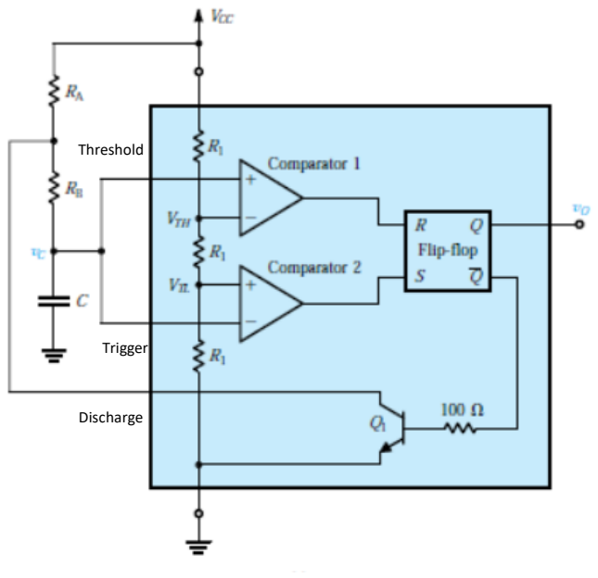
[picture p28: figure]
Threshold; Trigger; Discharge

آلية عمل القادح:

في البداية تكون المكثفة غير مشحونة أي يكون جهد النقطتين Threshold،Trigger صفراً وبالتالي يكون خرج المقارن األول صفر وخرج المقارن الثاني واحد. ولذلك يكون خرج القالب Flop-Flip واحد وبالتالي يكون الترانزستور 1 في النمط القاطع. يتم شحن المكثفة من المنبع CV عبر المقاومتين R ,R حتى يصل فرق الجهد بين طرفيها إلى القيمة TV عندها يتغير خرج المقارن األول من صفر إلى واحد ناقالً بذلك خرج القالب من واحد إلى صفر وبالتالي يصبح الترانزستور 1 في النمط الفعال. نتيجة لتغير حالة الترانزستور يتم تفريغ المكثفة عبر المقاومة R حتى يصل الجهد بين طرفيها إلى القيمة TV عندها يتغير خرج المقارن الثاني من صفر إلى واحد وهذا يؤدي إلى تغير خرج القالب من واحد إلى صفر ويعود الترانزستور 1 إلى النمط القاطع وتتكرر عملية الشحن والتفريغ.

Figure 26 دارة 555 كقادح مهتز

حساب زمن شحن وتفريغ المكثفة:

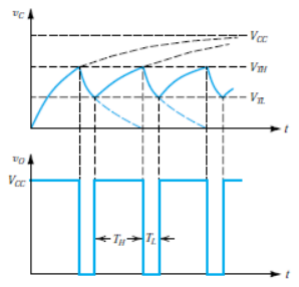
[picture p29: figure]

زمن الشحن: يتم شحن المكثفة من المنبع CV عبر المقاومتين R ,R . عند بدء عملية الشحن يكون الجهد بين طرفي المكثفة مساوياً ل TV )في الحالة المستقرة( بالتالي:

Vc

(t) = Vcc − (Vcc − VTL) exp (−

t
C(RA + RB)

)

زمن الشحن T:

Vc

(TH) = VTH = Vcc − (Vcc − VTL) exp (−

TH
C(RA + RB)

)

لكن من بنية مؤقت 555 نالحظ أنَّ عالقة الجهود TV ,TV بالجهد CV هي عالقة تقسيم فولطية:

VTH =

2
3

VCC

VTL =

1
3

VCC

ℎ c: | بالتعويض نجد أن زمن الشحن

TH = C(RA + RB) ln 2 ≃ 0.69C(RA + RB)

زمن التفريغ: يتم تفريغ المكثفة عبر المقاومة R فقط. عند بدء عملية التفريغ يكون الجهد بين طرفي المكثفة مساوياً لTV بالتالي:

Vc

(t) = Vcc − (Vcc − VTH) exp (−

t
CRB

)

⇒ Vc

(TL

) = VTL = Vcc − (Vcc − VTH) exp (−

TL
CRB

)

| معادلة زمن التفريغ
:

Figure 27 جزء شحن وتفريغ المكثفة C

TL = CRB ln 2 ≃ 0.69CRB

ومنه دور إشارة الخرج :

T = TL + TH = 0.69C(RA + 2RB)

أي خرج القادح المهتز هو إشارة دورية مربعة دورها يُعطى بالعالقة السابقة.

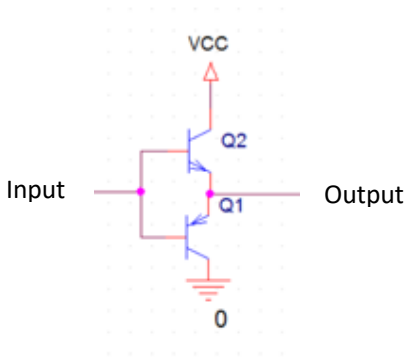
[picture p30: figure]
Input; Output

مضخم pull-push من الصنف AB:

خرج دارة 555 تيار محدود قد ال يكون كافي لتغذية كافة مضخمات العمليات لذلك نحتاج إلى مرحلة تقوم بتأمين التيار الالزم لقيادة كل مضخمات العمليات. يتم وصل كل من الترانزستورين 21, بتقنية المجمع المشترك )collector common )حيث تحافظ تقنية الوصل هذه على مطال إشارة الدخل تقريباً لكن تساهم بتضخيم تيار الدخل بنسبة .

دارة استعادة DC
خرج مرحلة pull push هو إشارة مربعة مطالها بين 0 وCV. لتوليد جهد سالب علينا أن نحصل أوالً على إشارة سالبة لذلك نحتاج إلى Circuit Clamper لتنقل مطال اإلٍشارة من 0 وCV إلى 0 وCV.−

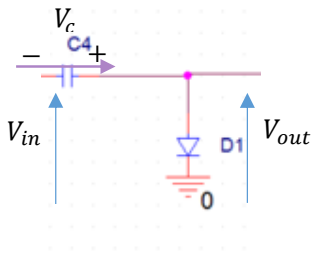
[picture p31: figure]
Vin; Vout

Figure 29 دارة استعادة DC

Push Pull | مضخم | 28 Figure

عندما يكون الدخل في المستوى العالي أي CV يكون الديود في النمط ON وبالتالي lov 0 = uoV لكن بتطبيق كيرشوف:

Vout = Vin + Vc

CV− = أي أن جهد اللبوس الموجب هو صفر وجهد اللبوس السالب هو | بالتالي عندما يكون 0 = uoV يكون
CV. عندما ينتقل الدخل من CV إلى الصفر لحظياً )بحكم أن اإلشارة مربعة( فإن المكثفة تمانع التغير المفاجئ لفرق
| الجهد بين طرفيها بالتالي يحافظ

على قيمته والتي هي CV− لكن جهد اللبوس السالب أصبح صفر بالتالي جهد
اللبوس الموجب أصبح CV− والديود في النمط OFF بالتالي أصبح جهد الخرج CV− .

بهذا التحليل تقوم الدارة السابقة بتوليد إشارة خرج مربعة مطالها بين 0 وCV.−

دارة مالحقة قمم سالبة
المرحلة األخيرة من دارة توليد التغذية السالبة هي دارة مالحقة قمم سالبة وبما أن إشارة الدخل هي إشارة مربعة بين 0 وCV− فيوجد قمة وحيدة هي CV− وبالتالي الخرج هو قيمة ثابتة CV− وهذا هو المطلوب.

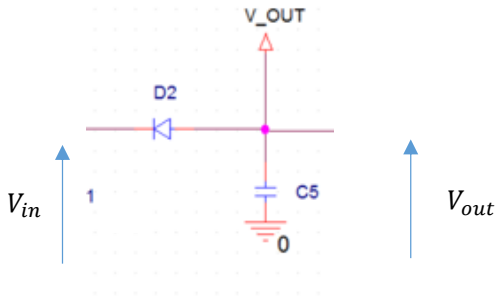
[picture p32: figure]
Vin; Vout

عندما يكون الدخل في المستوى 0 يكون الديود في النمط OFF والخرج صفر. عندما ينتقل الخرج إلى المستوى CV− يصبح الديود في النمط ON ويتم شحن المكثفة حتى يصبح جهد الخرج CV− . ثم يصبح الديود في النمط OFF عندما يعود الدخل إلى المستوى صفر يبقى الديود في النمط OFF( حيث أن فرق الجهد بين طرفيه سالب(. وبالتالي يبقى جهد الخرج CV.−

عملياً سيكون هنالك حمل يسحب تيار من المكثفة عندما يكون الديود في النمط OFF بالتالي سيؤدي ذلك إلى أن يصبح جهد الخرج أكثر من CV− ويتم تعويض هذا الفرق عندما يصبح الدخل في المستوى CV− . بالتالي سيكون هنالك اهتزاز في جهد الخرج لذلك نقوم باختيار مكثفة بسعة كبيرة بحيث ال يتأثر جهد الخرج بالتيار المسحوب خالل الفترة التي يكون فيها الديود في النمط OFF.

2 . 1 . 1 . .5 تصميم دارة التغذية السالبة
- تم اختيار عناصر دارة 555 كالتالي
R1 = 10 k , R2 = 1 k , C3 = 10 nF , C1 = 0.047nF بحيث 2 ≪ 1 ليكون زمن الهبوط يساوي تقريباً زمن الصعود. فيكون دور إشارة الخرج
T = 0.69C3

(2R1 + R2

) = 0.15ms

Figure 30 دارة مالحقة قمم

- اختيرت قيمة μ11 = 4 بحيث ال يتأثر الجهد بين طرفيها بالتيار المسحوب عندما يكون .D1 OFF and D2 ON
- اختيرت μ 1001 = 5 بحيث ال يتأثر جهد الخرج uoV بالحمل )lams leppirV(:

Vr =

Vp

fC3Rload

=

1.5

Rload

ونظراً الستخدام التغذية السالبة لتغذية المضخمات العمليات

Rload ≫ 1.5 ⟹ Vr ≈ 0

بنمذجة الدارة كانت النتيجة كما يلي

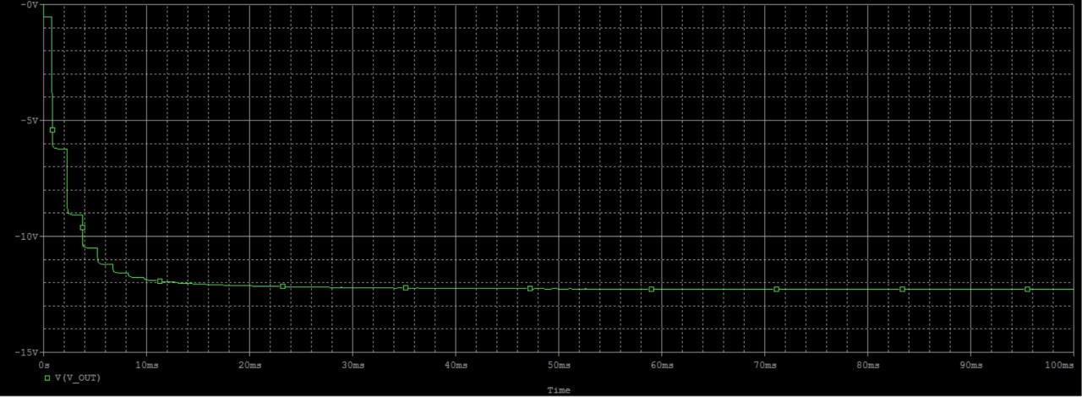
[picture p33: figure]

Figure 31 خرج دارة التغذية السالبة

2 1. .5. التغذية الموجبة
بحكم أنه يوجد فقط وحدة تغذية وحيدة فنحن محدودون بمنبع جهد وحيد لتغذية مضخمات العمليات. ولتوليد التغذية السالبة بمطال volt 10 تم تثبيت جهد هذا المنبع على volt .15

لذلك للحصول على تغذية موجبة قريبة من قيمة التغذية السالبة بالقيمة المطلقة تم استخدام regulator voltage يعطي على خرجه volt .9

وتم توصيله بالشكل الموضح.

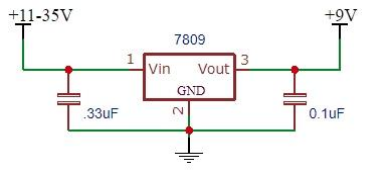
[picture p34: figure]

دارة المنظم32 Figure

2 .5. توليد إشارة القيادة
لقيادة المحرك سنتبع طريقة اإلشارتين المترابعتين

1 2. .5. توليد إشارتي دخل بفرق صفحة 90 )Shifter Phase) لتوليد إشارات قيادة محرك بفرق صفحة 90 تم استخدام قالبين نوع D كما يظهر المخطط:

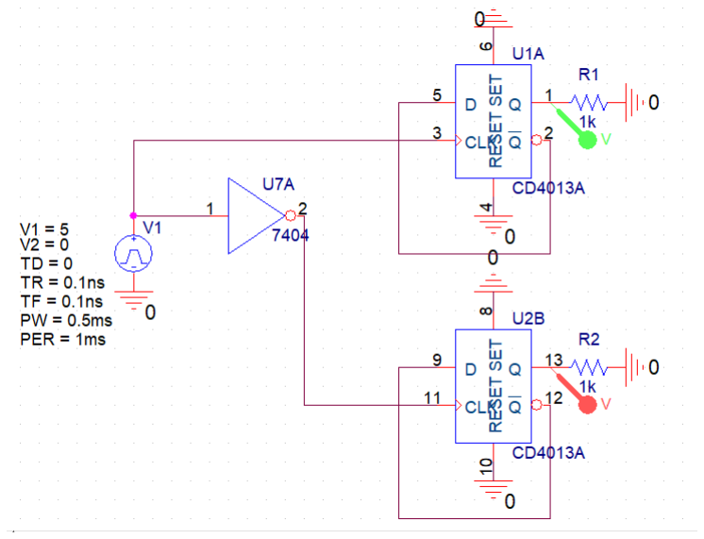
[picture p35: figure]

Figure 33 دارة توليد فرق الطور

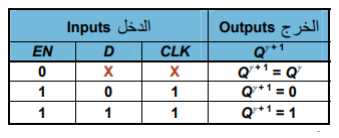
[picture p36: figure]

Table 1 جدول الحقيقة لقالبD
اعتماداً على جدول الحقيقة لقالب D، نجد أنه بوصل مع ̅ يتغير خرج القالب مع كل نبضة صاعدة إلشارة الساعة، بالتالي لتوليد إشارتين مترابعتين يتم إدخال إشارة مربعة لساعة القالب األول بحيث يعطي الخرج إشارة مربعة أيضاً لكن بتواتر هو نصف تواتر نبضة الساعة، وأخذ معكوس إشارة الدخل كدخل لساعة القالب الثاني فيكون الخرج عبارة عن إشارة متأثرة بالنبضة الهابطة للساعة فيتولد لدينا إشارتين مزاحتين عن بعضهما إزاحة مقدارها 90 درجة وبتواتر هو نصف تواتر إشارة الدخل.

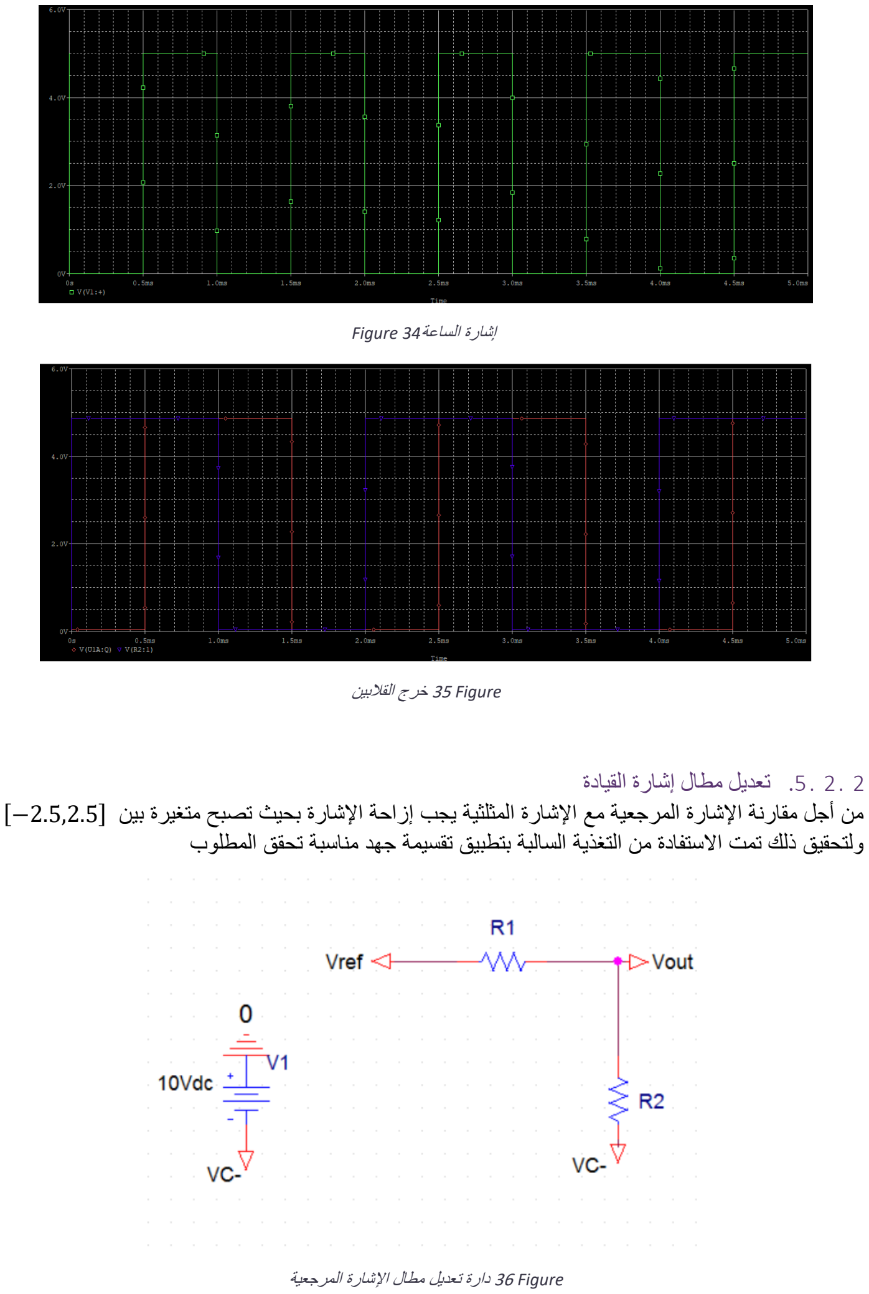
[picture p37: page 29]

إشارة الساعة34 Figure

Figure 35 خرج القالبين

2 2. .5. تعديل مطال إشارة القيادة من أجل مقارنة اإلشارة المرجعية مع اإلشارة المثلثية يجب إزاحة اإلشارة بحيث تصبح متغيرة بين [−2.5,2.5] ولتحقيق ذلك تمت االستفادة من التغذية السالبة بتطبيق تقسيمة جهد مناسبة تحقق المطلوب

Figure 36 دارة تعديل مطال اإلشارة المرجعية

تحليل الدارة وتصميمها

wℎen Vref = Vℎigℎ ⟹ Vout =

R2
R2 + R1

Vℎigℎ +

R1
R2 + R1

Vc−

wℎen Vref = 0 ⟹ −Vout =

R1
R2 + R1

Vc−

عملياً كان مطال اإلشارة المرجعية lov 4 = erV وقيمة التغذية السالبة lov −10 = −V

بالتالي

Vref = 4 ⟹ Vout =

R2
R2 + R1

4 +

R1
R2 + R1

(−10)

Vref = 0 ⟹ −Vout =

R1
R2 + R1

(−10)

1 بفرض =
R2

Vout =

4
1 + x

4 +

x
1 + x

(−10)

−Vout =

x
1 + x

(−10)

بتقسيم المعادلتين السابقتين

x =

1
5
بتعويض المعادلة الثانية باألولى

2Vout =

4
x + 1

⟹ x =

2

Vout

− 1

⟹

2

Vout

− 1 =

1
5

⟹ Vout = ±

5
3

بالتالي تم اختيار Ω k10 = 1 Rو Ω k50 = 2R

3 2. .5. التحكم بجهة الدوران لعكس جهة دوران المحرك يجب أن تصبح إشارتي القيادة المترابعتين بتقديم 90 درجة، مترابعتين بتأخير 90 درجة بالتالي لتحقيق الفكرة السابقة تم استخدام مبدل)switch )من النوع )throw double pole single ) وتوصيلها بالشكل التالي إلى جسر القيادة)bridge_H )

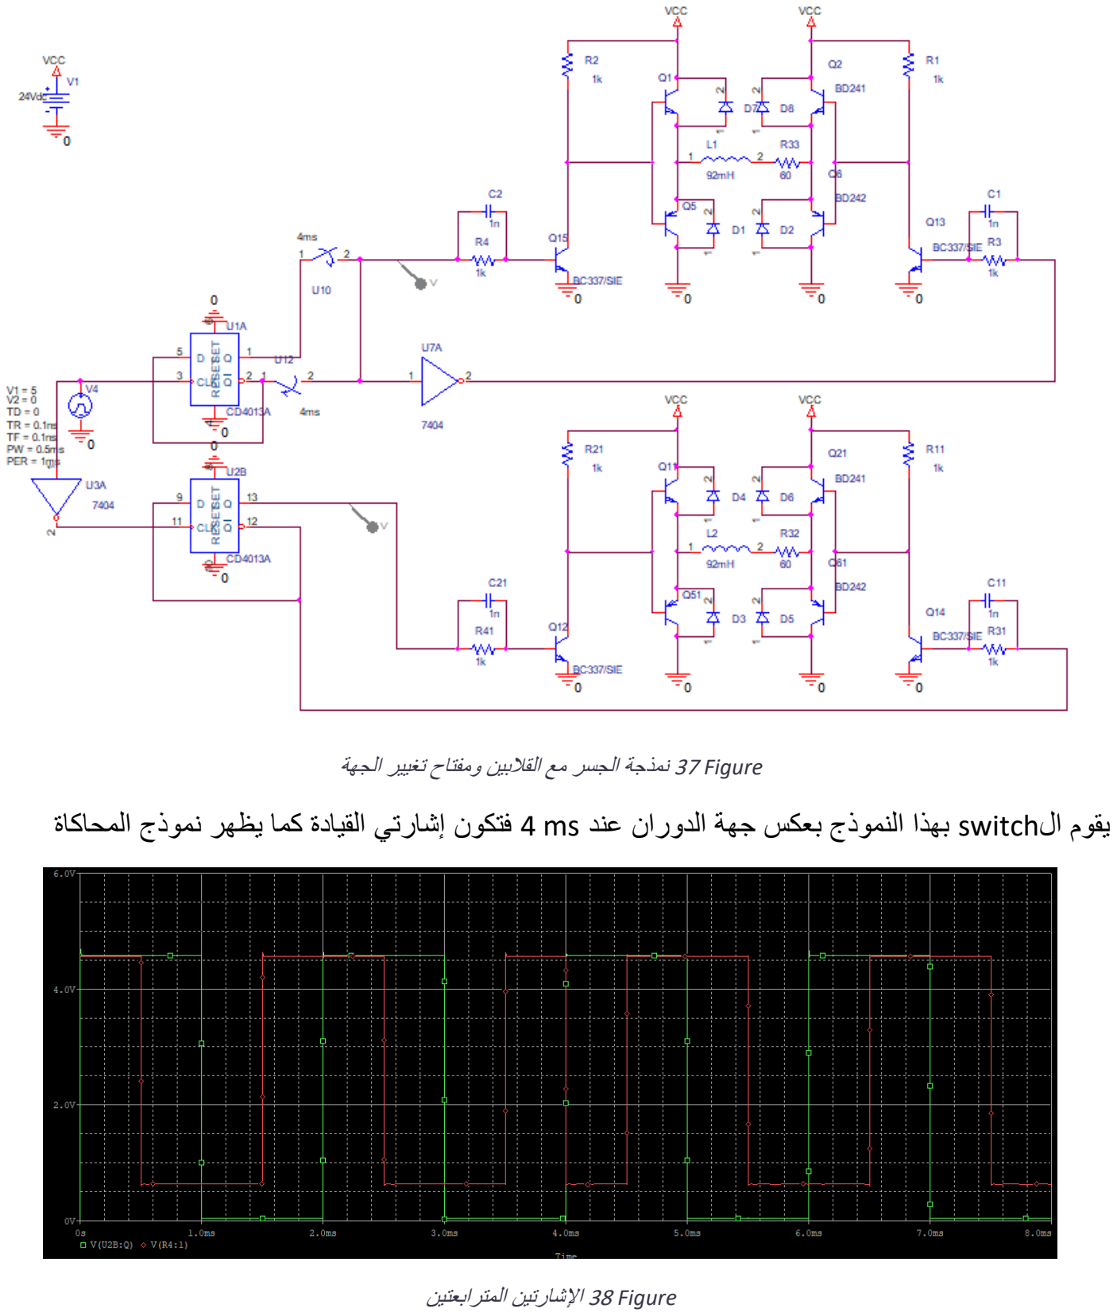
[picture p38: page 31]

Figure 37 نمذجة الجسر مع القالبين ومفتاح تغيير الجهة

يقوم الswitch بهذا النموذج بعكس جهة الدوران عند ms 4 فتكون إشارتي القيادة كما يظهر نموذج المحاكاة

Figure 38 اإلشارتين المترابعتين

Voltage to frequency circuit .5. 3

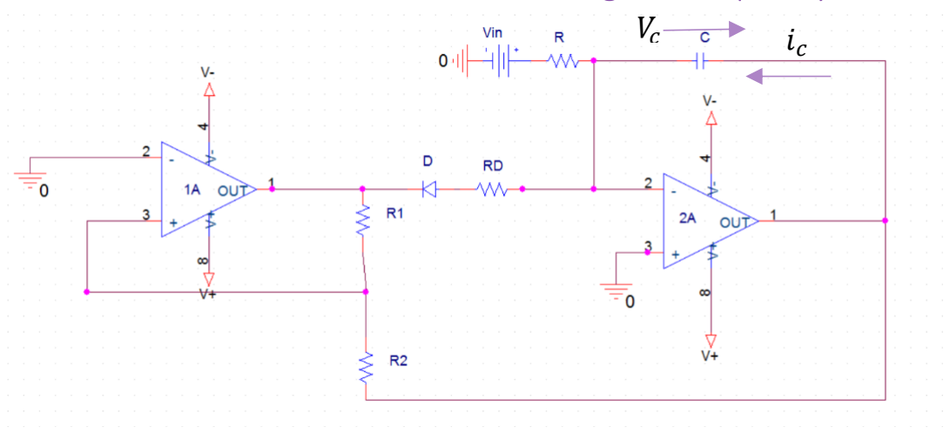
[picture p39: figure]

voltage to frequency دارة 39 Figure

تقوم هذه الدارة بتوليد نبضات مربعة ذو مطال ثابت يتعلق بقيم +V و-V وبتردد متناسب مع قيمة الجهد المستمر .Vin

1 3. .5. تحليل الدارة
م ضذخم العمليات 1A يعمل كمقارن حيث يكون خرجه هو إما +L أو -L ح سذب قيمة الجهد عند المدخل الموجب له. بالحالة المثالية قيم +L و-L تكون مساوية لقيم التغذية +V و-V على الترتيب.
- إيجاد عتبات الجهد التي يقوم عندها المقارن بتغيير قيمته:

يتم إيجاد عالقة الجهد للمدخل الموجب باسذتخدام نظرية التراكب. بوضذع خرج 1A صذفر نحصذل على عالقة المدخل الموجب مع خرج 2A:

V+ =

R1
R1 + R2

Vo2

بوضع خرج 2A صفر نحصل على عالقة المدخل الموجب مع خرج 1A:

V+ =

R2
R1 + R2

Vo1

وبالتالي تصبح عالقة المدخل الموجب:

V+ =

R2
R1 + R2

Vo1 +

R1
R1 + R2

Vo2

بما أن 1A يعمل كمقارن فخرجه هو إما +L أو -L. لنفترض أنه +L أي أن جهد المدخل الموجب أكبر من جهد المدخل السالب:

V+ =

R2
R1 + R2

L+ +

R1
R1 + R2

Vo2

يغير 1A قيمته إلى -L عندما يصبح جهد المدخل الموجب أقل من جهد المدخل السالب أي عندما يصبح جهد المدخل الموجب أقل من الصفر:

0 =

R2
R1 + R2

L+ +

R1
R1 + R2

Vo2

⟹ Vo2 = −

R2
R1

L+

2 | أي عندما يصل جهد خرج 2A إلى القيمة −
R1

+ ينتقل جهد خرج 1A من +L إلى -L. بنفس الطريقة عندما يصل
2 | جهد خرج 2A إلى القيمة −
R1

− ينتقل جهد خرج 1A من -L إلى +L. أما مضخم العمليات 2A فهو يعمل

كمكامل عاكس. جهد المدخل السالب له يساوي جهد المدخل الموجب: V+ = V−

iV | وبالتالي التيار الذي يمر في المقاومة هو
R

وباختيار R ≪ عندما يكون خرج 1A هو -L يكون الديود D
2 | في النمط ON وبالتالي يتم تفريغ المكثفة C عبر المقاومة R حتى يصبح خرج 2A يساوي − = 2V
R1

− عندها
i عبر | ينتقل خرج 1A من -L إلى +L ويصبح الديود D في النمط OFF. في هذه الحالة يتم شحن المكثفة من
2 | حتى يصبح خرج 2A يساوي − = 2V
R1

+ عندها ينتقل خرج 1A إلى المستوى -L ويصبح D في النمط ON

وتتكرر عملية الشحن والتفريغ.

حساب زمن شحن وتفريغ المكثفة C
- زمن التفريغ

عندما D في النمط ON:

ic = c

dVc
dt ⟹ −

L−
RD

−

Vin
R

= c

dVc
dt , Vc
(0) = −

R2
R1

L+

⟹ Vc

(t) = − (

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
− = | بتعويض

R2
R1

− نحصل على زمن التفريغ 1:

Vc

(t1

) = −

R2
R1

L− = − (

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
⟹ t1 =

c

R2
R1

(L+ − L−)

−

L−
RD

−

Vin
R
− ,i من نفس الرتبة بالتالي نستطيع إهمال الحد | باعتبار R ≪ و

Vin
R
− | أمام الحد
RD

وباعتبار −− = +

تصبح عالقة 1:

t1 ≃ 2c. RD.

R2
R1
- زمن الشحن

عندما D في النمط OFF:

ic = c

dVc
dt ⟹ −

Vin
R

= c

dVc
dt , Vc
(0) = −

R2
R1

L−

⟹ Vc

(t) = −

Vin
R. c

t −

R2
R1

L−

− = | بتعويض

R2
R1

+ نحصل على زمن التفريغ 2:

Vc

(t2

) = −

R2
R1

L+ = −

Vin
R. c

t2 −

R2
R1

L+

⟹ t2 =

R2.R. c
R1.Vin

(L+ − L−)

وباعتبار = −− = +

t2 ≃

R2.R. c. L
R1. Vin

ضمن نطاق عمل دارتنا سيكون iV < وبالتالي نالحظ أن:

t1
t2

<

RD
R

وذكرنا مسبقاً أن R ≪ بالتالي 1 ≪ 2 أي نستطيع إهمال زمن التفريغ مقارنة بزمن الشحن:

f = k. Vin =

R1
R2.R. c. L

Vin

i الممكن. | يُسمى بمفتاح حساسية الدارة ويتم اختياره وفقاً لمجال الترددات الذي نريده ومجال تغيرات

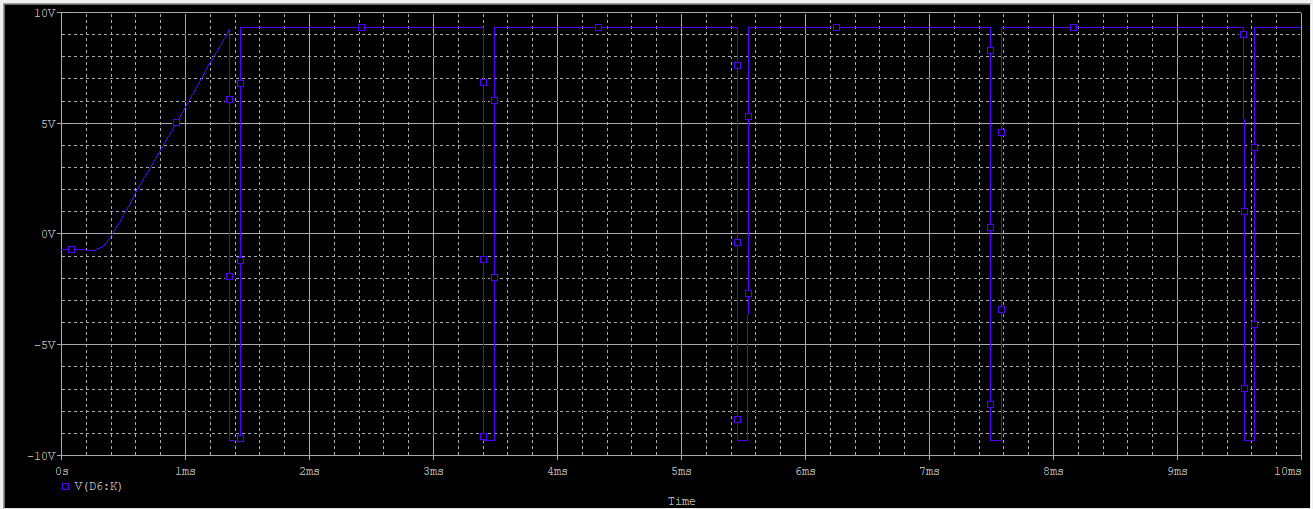
[picture p40: figure]

voltage to frequency دارة | خرج 40 Figure

2 3. .5. تعديل عرض ومطال خرج دارة VTF من كون خرج الدارة هو دخل لمولد اإلشارة المرجعية )قالب D )فإن مطالها غير مناسب كدخل لبوابة منطقية وعرضها غير مناسب لتوليد إشارات القيادة المترابعة بالتالي تحتاج لتعديل مطال وعرض النبضة.

تعديل المطال
لتعديل مطال اإلشارة استخدمنا دارة من الشكل

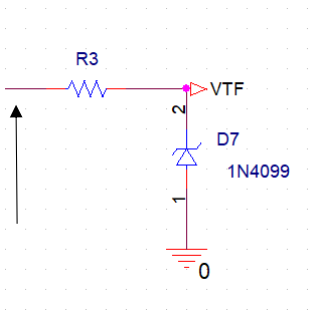
[picture p41: figure]

عندما تكون Vin موجبة يقوم ديود زينر بتحديد المطال على volt 5 وعندما تكون سالبة يكون الديودON فيكون الخرج 0 .

تعديل العرض
لتوليد إشارتي القيادة المترابعتين نحتاج إلشارة ساعة يكون نصف دورها بالمستوى المرتفع والنصف الثاني بالمستوى المنخفض، ولتحقيق ذلك يتم إدخالها إلى قالب ثالث المدخل D له موصول ب̅.

تكون الدارة النهائية بالشكل:

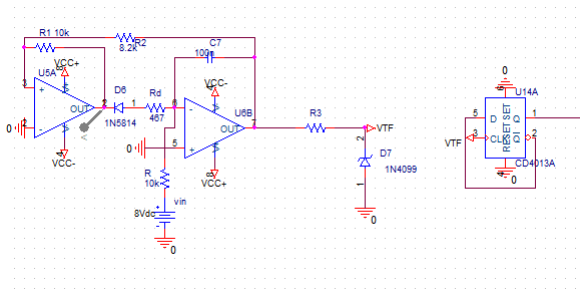
[picture p42: figure]

التعديل بعد Voltage to frequency دارة 41 Figure

3 3. .5. تصميم عناصر دارة frequency to Voltage نختار مفتاح الحساسية اعتماداً على مجال الترددات المطلوبة ليدور المحرك بمجال سرعة PR[0,300].

motor step = 1.8

o ⟹ one turn = 360o = 200 × step

نقود المحرك بطريقة طوران يعمالن في كل دور بالتالي في كل دور من إشارة التحكم يتحرك الدائر 4 خطوات

Vin

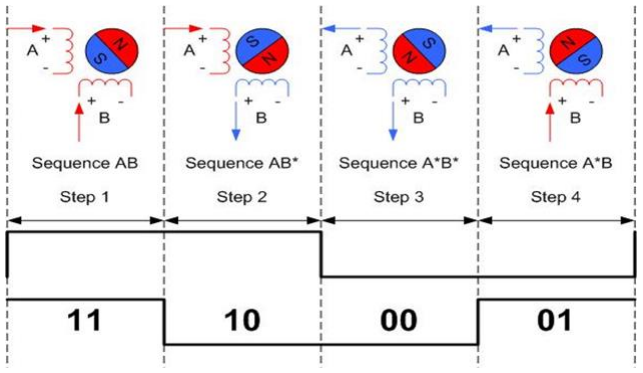
[picture p43: figure]

فمن أجل سرعة عظمى PR 300 يكون التردد المطلوب

300 RPM =

300
60

× 200 = 10³
step per second ⟹ fref =

10³
4

= 250 Hz

كون إشارة القيادة التي يكون ترددها األعظمي H ،250 تنتا عن مرور خرج دارة frequency to voltage عبر قالبين بالتالي التردد األعظمي لدارة frequency to voltage:

fvtf = 2 ∗ 2 ∗ fref = 1000 Hz

تم اختيار مجال دخل دارة frequency to voltage:

Vin ∈ [0,10] volt

⟹ K =

fvtf

Vin,max

=

R1
R2.R. c. L

= 100 Hz/volt

تم اختيار قيم العناصر حيث lov 12 =

R1 = 10 kΩ

R2 = 8.2 kΩ

R = 10 kΩ

Rd = 470 Ω

C = 100 nF

⟹ K = 101 Hz/volt

4 .5. مولد اإلشارة المثلثية )Generator Form Wave)

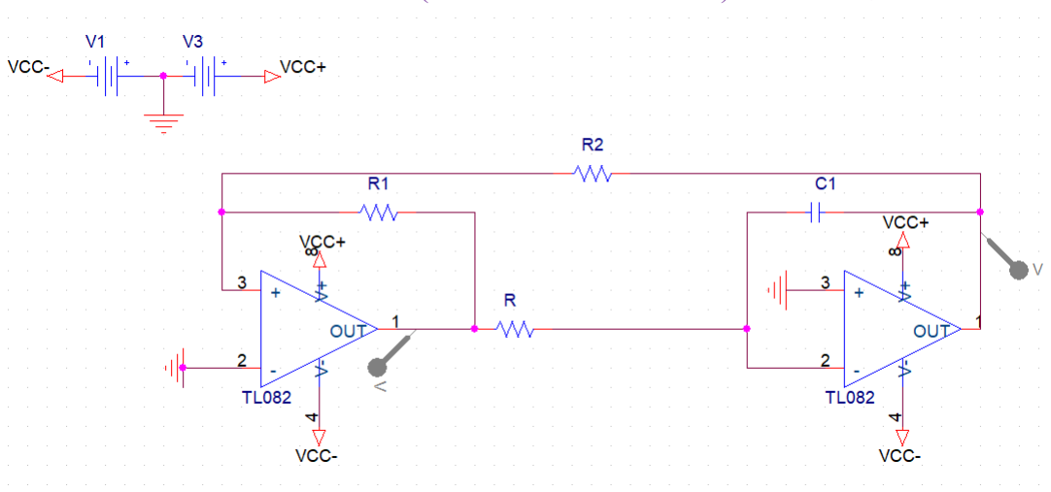
[picture p44: figure]

Figure 42 دارة توليد إشارة مثلثية

تم توليد إشارة مثلثية اعتماداً على الدارة التالية.

مبدأ عمل الدارة:
تتألف الدارة من جزأين جزء يعمل كمقارن بين الجهد على طرفي المضخم وجزء يعمل كمكامل، بحيث يكون خرج
as | المضخم األول )المقارن( هو إشارة مربعة بين )

+ , vsat
( وخرج المضخم الثاني)المكامل( هو إشارة مثلثية | −
ناتجة عن مكاملة إشارة الدخل )اإلشارة المربعة(.

1 4. .5. تحليل الدارة:
جزء المقارن
يعمل المقارن على المقارنة بين − , + وتكون قيمة كل منهما كالتالي

v+ =

R2
R1 + R2

vO1 +

R1
R1 + R2

vO2

v− = 0

تصبح قيمة _ < + فيعطي خرج المقارن قيمة عليا تدل على | + | عند قيمة معينة لدخل المقارن ولتكن v = 2v
as | قيمة المقارنة وهي قيمة االشباع المضخم
، وتكون معادلة الخرج عند نقطة القلب: | +

0 =

R2
R1 + R2

vsat

+ +

R1
R1 + R2

vp

+ ⟹ vp

+ = −

R2
R1

vsat

+

بحيث | − | وبنفس الطريقة تصبح _ > + عند قيمة معينة للدخل v = 2v

vp

− = −

R2
R1

vsat

−

جزء المكامل
as | من جهة أخرى من كون المضخم الثاني يعمل كمكامل إلشارة 1v وهي إشارة مربعة بين )

+ , vsat
( يكون | −
خرجه إشارة مثلثية بحيث (cip t cip ) pv تساوي التكامل على نصف الدور

حسب مبدأ superposition

vpp = −

1
RC ∫ vsat
−

T
2

0

dt =

vsat
RC (

T
2

)

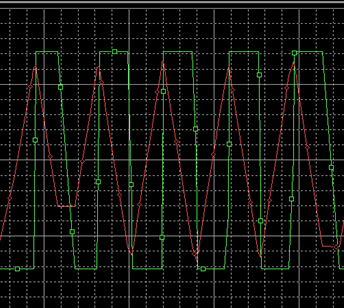
[picture p45: figure]

Figure 43 خرج دارة مولد اإلشارة المثلثية

من كون إشارة التكامل كما تظهر اإلشارة الحمراء في الشكل-- تكون قيمة قلب المقارن إلى قيمة اإلشباع الموجبة

vsat

cipv = ⁺ | هي v | +

+
بالتالي نجد:

vpp = vp

+ − vp

− = −

R2
R1

vsat

+ +

R2
R1

vsat

− = −

2R2
R1

vsat

asv− = ⁺ | حيث asv
− | = vsat

بالتعويض بالعالقة—نجد

vpp =

2R2
R1

vsat =

vsat
RC (

T
2

) ⟹ T =

4R2
R1

RC ⟹ f =

R1
4R2

(

1
RC)
22 | فالدارة التالية عبارة عن هزازة تقوم بتوليد إشارة مثلثية بتردد وبمطال = pv
R1

vsat .

2 4. .5. تصميم الدارة
لتوليد نبضات WP يجب أن يكون تردد اإلشارة المثلثية أكبر بكثير من تردد إشارات القيادة المرجعية

ft ≫ fref ⟹ ft = 13 KHz

ft =

R1
4R2

(

1
RC) = 13 KHz

بالتالي تم اختيار قيم عناصر الدارة

R1 = 10 kΩ

R2 = 8.2 kΩ

R = 2.3 kΩ , C = 10 nF

5 .5. توليد إشارات PWM

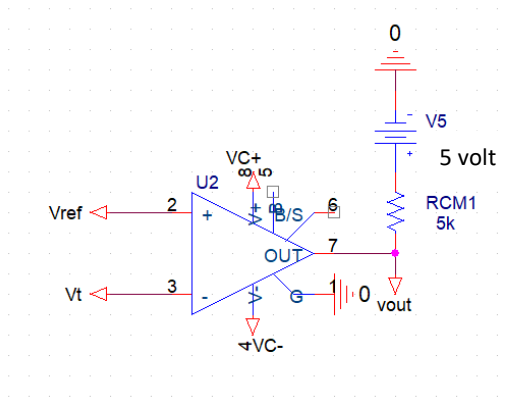
[picture p46: figure]
5 volt

Figure 44 مولد إشارة PWM

لتوليد إشارات متغيرة عرض النبضة نستخدم مقارن للمقارنة بين إشارات القيادة المرجعية وإشارة المثلثية.

تم استخدام مقارن من نوع 311LM يتم تغذيته ب volt 10 و volt .-10 خرج هذا المقارن موصول على مجمع ترانزستور ونتيجة المقارنة تحدد إما أن يفتح أو يغلق هذا الترانزستور لذلك عندما يكون المدخل الموجب للمقارن أكبر من المدخل السالب للمقارن يتم فتح هذا الترانزستور وبالتالي سحب جهد الخرج إلى الصفر وعندما يكون جهد المدخل السالب أكبر من جهد المدخل الموجب يتم فتح هذا الترانزستور وبالتالي يكون جهد الخرج volt .5

### .6 تصحيح التيار

في البداية لتفسير حاجتنا لمصحح تيار نحتاج لفهم نظام المحرك.

1 .6. نموذج المحرك:
يمكن نمذجة المحرك كهربائياً بالشكل-- حيث هي مقاومة أسالك الثابت لطور واحد و هي ذاتية ملفات الثابت للطور، بقياس قيمة كل منهما كانت

R = 60 Ω

L = 92 mH

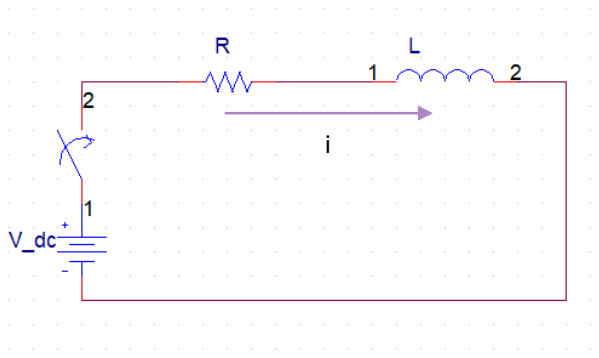
[picture p47: figure]

Figure 45 نموذج المحرك الخطوي

Vdc = Ri + L

di
dt
بتطبيق تحويل البالس

Vdc = RI + Lp I ⟹

I

Vdc

=

1
R + Lp

بالتالي ينمذج نظام المحرك الخطوي بنظام درجة أولى من الشكل

G =

1
Lp + R

وقد تم التأكد من نموذج النظام عملياً بتدوير المحرك بالحلقة المفتوحة عند أصغر تردد مرجعي ممكن)= H 17( يكفي لتدويره بحيث يكون التيار قادراً على الوصول إلى االستقرار ومالحقة الدخل المرجعي ومن ثم رسم إشارة التيار على راسم االهتزاز فكان شكل تابع االستجابة يكافئ شكل تابع استجابة نظام درجة أولى.

ومن كون قياس الذاتية ذو ارتياب كبير نظراً لسوء مقاييس الذاتية تم التأكد من معامالت النظام بحساب زمن االستجابة عملياً فكانت النتائا:

esm 6 = | من أجل تردد H 17 = كان زمن االستجابة

tr = 3τ =

3L
R

= 6 × 10⁻³ ⟹ L = R ∗

0.0112
3

= 0.12 H = 120 mH

من حساب زمن االستجابة عملياً نجد أنه بحالة تطبيق دخل مرجعي بدور أقل من m 6 لن يقدر التيار على الوصول إلى زمن االستجابة بالتالي لن يالحق إشارة الدخل المرجعية ولن يدور المحرك وهنا تأتي حاجتنا للمصحح الذي يجبر التيار على مالحقة الخرج.

2 .6. حلقة التحكم
لتصحيح التيار نستخدم مصحح P بالحلقة المغلقة بالشكل:

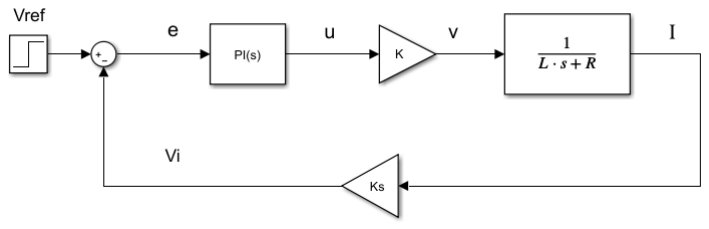
[picture p48: figure]

Figure 46 حلقة التحكم بالتيار

حيث هو ربح جسر القيادة وK هو نسبة تضخيم قائس التيار.

فيكون تابع تحويل الحلقة المغلقة من الشكل:

H =

I

Vref

=

K(Kpp + Ki)
Lp

2 + (R + KpKKs)p + KiKKs

1 2. .6. ربح جسر القيادة للتحكم بعمل جسر القيادة يجري توليد نبضات PWM من خالل المقارنة بين إشارة مثلثية ترددها أكبر بعشر أضعاف من تردد إشارة الدخل u المربعة

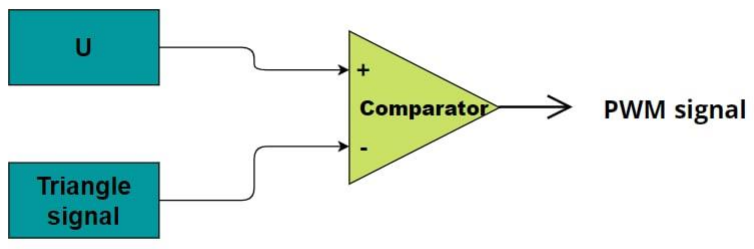
[picture p49: figure]

PWM المخطط الصندوقي ل47 Figure

τ/2

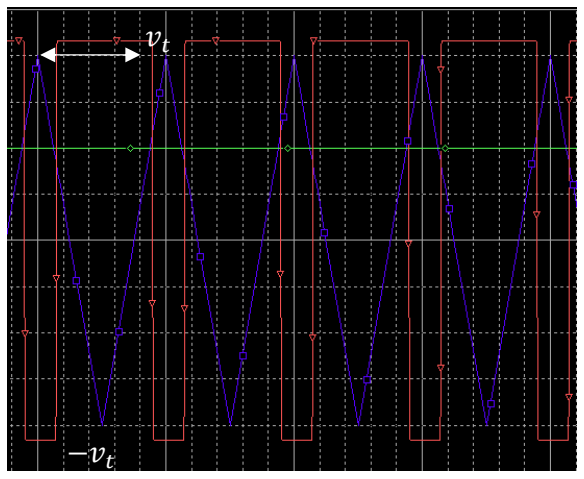
[picture p50: figure]

Figure 48 اإلشارة المثلثية واإلشارة المرجعية

معادلة اإلشارة المثلثية الصاعدة

v = at + b , wℎere

a =

vt—(−vt)
T/2

=

4vt
T
b = −vt

v(t) =

4vt
T

t − vt

يكون خرج المقارن 1 طالما () <

u >

4vt
T

t − vt ⟹ t <

T
4

(

u
vt

+ 1) ⟹ t ∈ [0,

T
4

(

u
vt

+ 1)]

بالتالي تكون

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
+ 1) ⟹ α =

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
+ 1)

ولما كانت القيمة الوسطى للجهد لجسرH تعطى بالعالقة dV(1 − 2) = ̅ بالتالي نجد

V̅ = (2α − 1)Vdc = (2

1
2

(1 +

u
vt

) − 1) Vdc =

Vdc
vt

u

dV | بالتالي يمكن نمذجة نظام المقارن مع الجسر بمعامل تناسبي =
vt

دخله هي اإلشارة المرجعية وخرجه هي
القيمة الوسطى للجهد المطبق على نظام المحرك ̅.

بالتطبيق العملي باستخدام النمذجة كان مطال اإلشارة المثلثية lov 3.2 وتم اختيار lov 24 = dV بالتالي:

K = 7.5

2 2. .6. تصميم قائس تيار )Measurements Current) أولى خطوات تصحيح التيار هو قياس تيار خرج دارة القيادة أي التيار المسحوب من المحرك بالتالي تم تصميم دارة قائس تيار يكون خرجها كمون موافق لقيمة التيار المار بالحمل

1 . 2 . 2 . .6 مبدأ عمل الدارة لقياس تيار مار بحمل ما نضيف مقاومة قياس على التسلسل مع الحمل وهي عبارة عن مقاومة صغيرة جداً بحيث ال تؤثر بقيمة الجهد المطبق على طرفي الحمل من ثم قياس فرق الكمون على طرفيها وتضخيمه بحيث نحصل على

aolI ≈ erusaemV lams ot nesR cnis aolI.nes | كمون موافق للتيار = erusaemV
> nes | يتم اختيار مقاومة القياس بحيث تكون أصغر بعشر مرات تقريباً من الحمل األومي

Rload
10

2 . 2 . 2 . .6 تحليل الدارة:

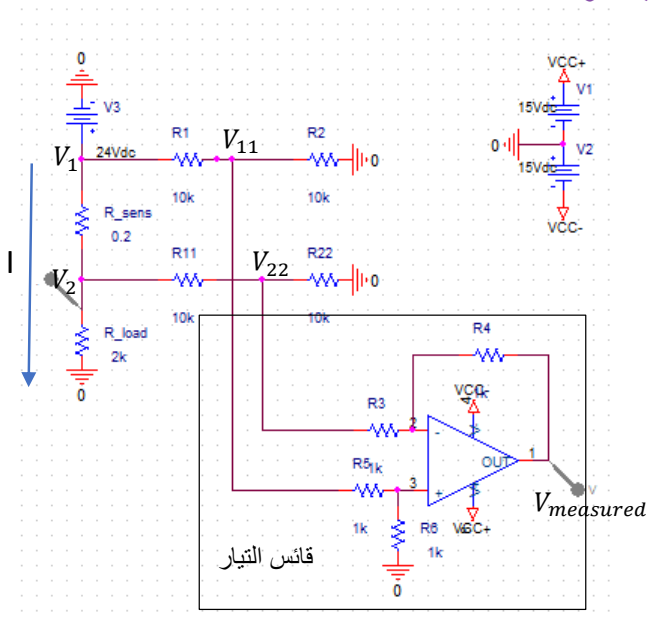
[picture p51: figure]
Vmeasured; قائس التيار

Figure 49 وصل دارة قائس التيار مع الحمل

في البداية من كون كمون المنبع volt 24 ستكون قيمة كل من 1 تساوي قيمة كمون المنبع و 2 أقل بقليل كون
صغيرة ال يمكن تطبيق جهد دخل على مضخم أكبر من كمون تغذيته وهو بحالتنا lov ±15 بالتالي يتم | nesR
تقسيم الجهد لكل من 2 و1 بنسبة متساوية ومناسبة بحيث يصبح كل منهما أقل من كمون تغذية المضخم أي

first condition |V11| < 15 , |V22| < 15

second condition

V11
V1

=

V22
V2

⟹

R2
R2 + R1

=

R22
R11 + R22

<

15
24

R22 = R2 , R1 = R11

بالتالي يكون

V1 − V2 =

R2 + R1
R2

(V11 − V22) = n. (V11 − V22), wℎere n =

R2 + R1
R2

في الحقيقة يوجد شرط ثالث على اختيار مقاومات تقسيم الجهد وهو أن تكون أكبر بكثير من مقاومة القياس بحيث ال يمر فيها تيار تقريباً أي يكون تأثيرها شبه معدوم

Rsens ≪ R1,R2

دارة القائس

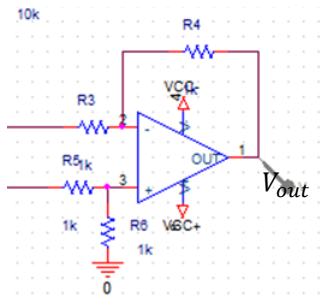
[picture p52: figure]
Vout

Figure 50 دارة قائس التيار

wℎen V11 = 0 ⟹ V+ = 0 ⟹ V− = 0 ⟹ −

V22
R3

=

Vout
R4

wℎen V22 = 0 ⟹

V+ =

R6
R6 + R5

V11

V− =

R3
R3 + R4

Vout

⟹ V+ = V− ⟹

R6
R6 + R5

V11 =

R3
R3 + R4

Vout

من 1 و 2 نجد

Vout = −

R4
R3

V22 +

R6
R6 + R5

R3 + R4
R3

V11

wℎen I = 0 ⟹ V1 = V2 ⟹ V22 = V11 , and Vout sℎould be 0

tℎen

R6
R6 + R5

R3 + R4
R3

=

R4
R3

⟹

R3 + R4
R6 + R5

R6 = R4 ⟹ we ℎave to cℎoose

R6 = R4
R3 = R5

وتكون نسبة تضخيم المصحح بهذه الحالة

Vout = A. ( V11 − V22 ), wℎere A =

R4
R3

I =

V1 − V2 Rsens
=
n Rsens | . (V11 − V22)

= K (ربح القائس) ⟹

Vout
I

= A.

Rsens
n

مالحظة عند التطبيق العملي على برناما المحاكاة الحظنا خطأ بنتيجة القياس سببه أن تقسيم الجهد غير مثالي بسبب إدخال القائس بين طرفي 2211, بالتالي تم استخدام Buffers لمنع دارة القائس من سحب تيار بالتالي أصبحت دارة القائس المستخدمة من الشكل:

V11

V22

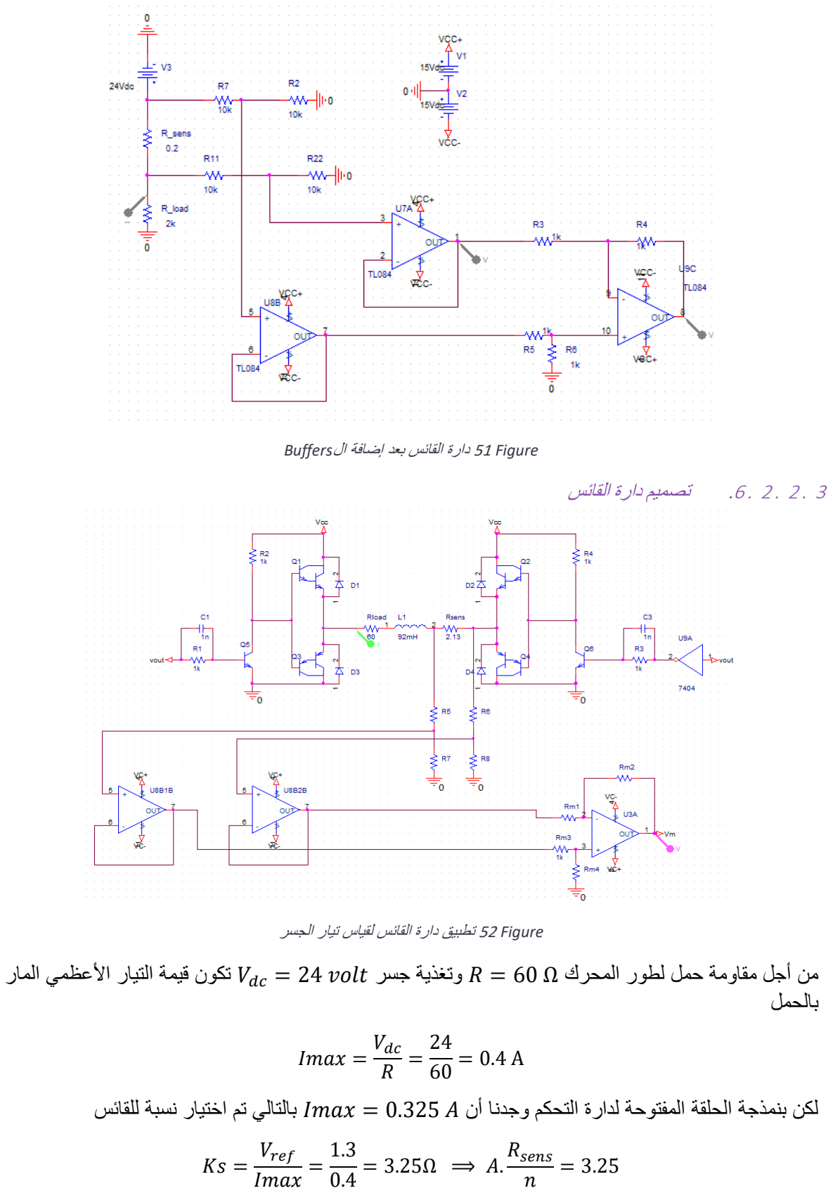
[picture p53: page 45]

Figure 51 دارة القائس بعد إضافة الBuffers

3 . 2 . 2 . .6 تصميم دارة القائس

Figure 52 تطبيق دارة القائس لقياس تيار الجسر

من أجل مقاومة حمل لطور المحرك Ω 60 R = وتغذية جسر lov 24 = dV تكون قيمة التيار األعظمي المار بالحمل

Imax =

Vdc
R

=

24
60 = 0.4 A

لكن بنمذجة الحلقة المفتوحة لدارة التحكم وجدنا أن 0.325 = amI بالتالي تم اختيار نسبة للقائس

Ks =

Vref
Imax =

1.3
0.4

= 3.25Ω ⟹ A.

Rsens
n

= 3.25

تم اختيار نسبة تقسيم جهد ليكون دخل مضخم العمليات للقائس أقل من جهد تغذيته بحالتنا )volt -10 10, )

1
n

=

1
4

⟹

R2
R1 + R2

=

1
4

R22 = 5 kΩ , R11 = 15 kΩ

واختيار nesR بحيث ال تؤثر على تيار الحمل بنسبة أكثر من 5%

Rsens = 2.13 ⟹ I =

Vdc

Rload + Rsens

| = 0.386 A = 96% of Imax

⟹ A = Ks ∗

n

Rsens

= 6.1 ⟹

R6 R5 | = 6.1 ⟹ R6 = 6 kΩ , R5 = 1 kΩ

3 .6. تصميم المصحح PI
1 3. .6. دارة المصحح

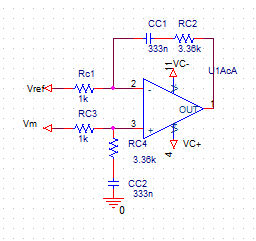
[picture p54: figure]

Figure 53 دارة المصحح

wℎen Vref = 0 ⟹

V− =

R1
1
C1s

+ R4 + R1

Vout

V+ =

1
C2s

+ R3
1
C2s

+ R3 + R2

Vm

⟹ V+ = V−

⟹

R1
1
C1s

+ R4 + R1

Vout =

1
C2s

+ R3
1
C2s

+ R3 + R2

Vm

wℎen Vm = 0 ⟹

V+ = 0 ⟹ V− = 0

Vref
R1

=

Vout
1
C1s

+ R4

⟹ CC1 = CC2 , RC2 = RC4 ,RC1 = RC3

Vout =

RC2 +

1
CC1s

RC1

(Vref − Vm)

⟹ C(s) =

RC2

RC1

+

1
RC1CC1s

⟹ Kp =

RC2

RC1

,Ki =

1

RC1CC1

2 3. .6. تصميم عناصر دارة المصحح كما وجدنا سابقاً إن تردد اإلشارة المرجعية الموافقة للسرعة األعظمية PR 300 يساوي H 250

fref = 250 Hz ⟹ Tref = 4 ms

بالتالي فترة تطبيق كل من الجزء الموجب والسالب من اإلشارة المرجعية هو m .2

لتحقيق عزم دوران يكفي لتدوير المحرك نختار زمن استجابة:

tr = 0.2 ∗ 0.5 ∗ Tref = 0.4 ms

K و باستراتيجية حذف صفر مع قطب، فكانت قيم K وK الموافقة لزمن االستجابة المطلوب: | تم حساب

Kp = 20.5 ,Ki = 13368

وتابع التحويل الناتا للنظام:

H(p) =

36.167
p + 1444.67

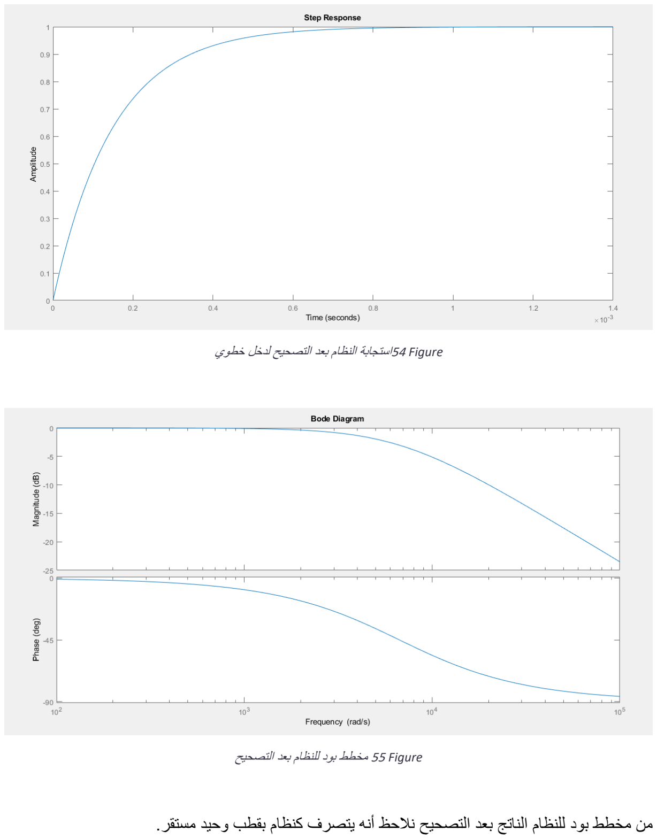
[picture p55: page 48]

Figure 54استجابة النظام بعد التصحيح لدخل خطوي

Figure 55 مخطط بود للنظام بعد التصحيح

من مخطط بود للنظام الناتا بعد التصحيح نالحظ أنه يتصرف كنظام بقطب وحيد مستقر.

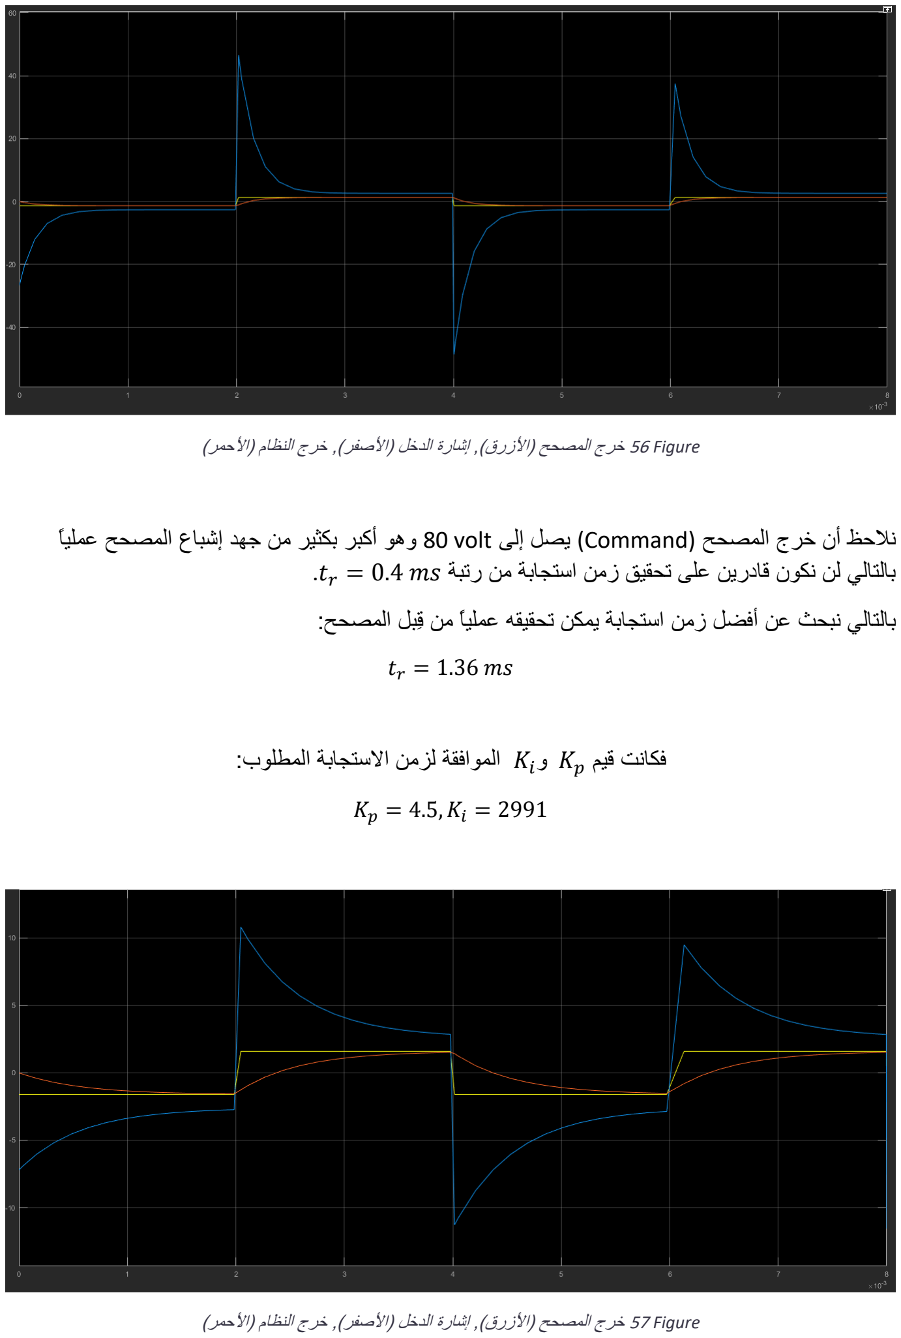
[picture p56: page 49]

Figure 56 خرج المصحح )األزرق(, إشارة الدخل )األصفر(, خرج النظام )األحمر(

نالحظ أن خرج المصحح (Command (يصل إلى volt 80 وهو أكبر بكثير من جهد إشباع المصحح عملياً
m 0.4 = . | بالتالي لن نكون قادرين على تحقيق زمن استجابة من رتبة

بالتالي نبحث عن أفضل زمن استجابة يمكن تحقيقه عملياً من قِبل المصحح:

tr = 1.36 ms

| فكانت قيم K و

الموافقة لزمن االستجابة المطلوب:

Kp = 4.5,Ki = 2991

Figure 57 خرج المصحح )األزرق(, إشارة الدخل )األصفر(, خرج النظام )األحمر(

اعتماداً على المحاكاة المطبقة تم اختيار قيم دارة المصحح:

RC2 = 4.5 kΩ

RC1 = 1 kΩ

Cc1 = 330 nF

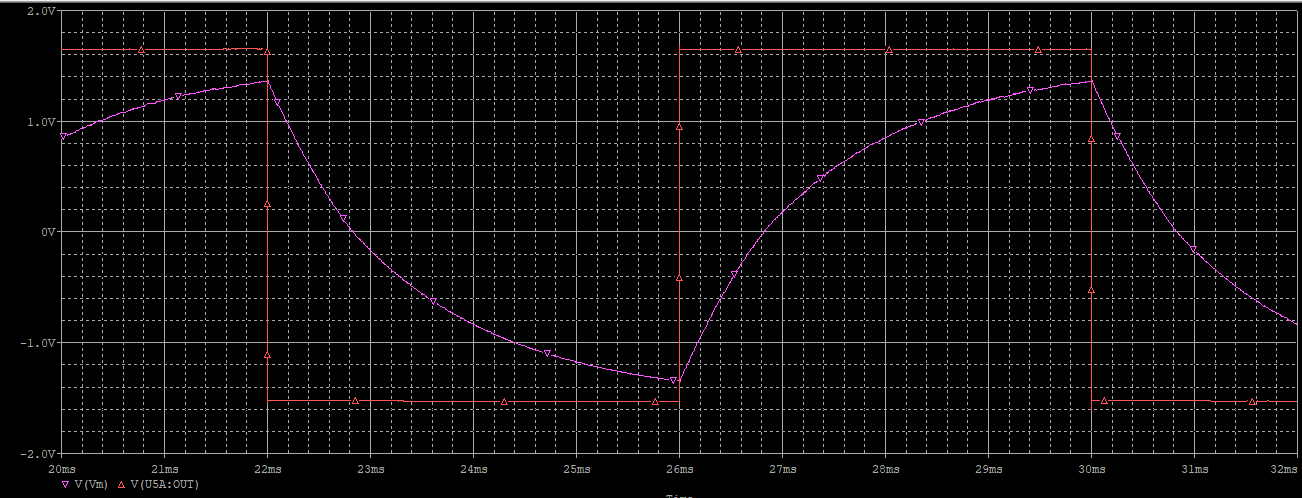
[picture p57: figure]

Figure 58 استجابة التيار

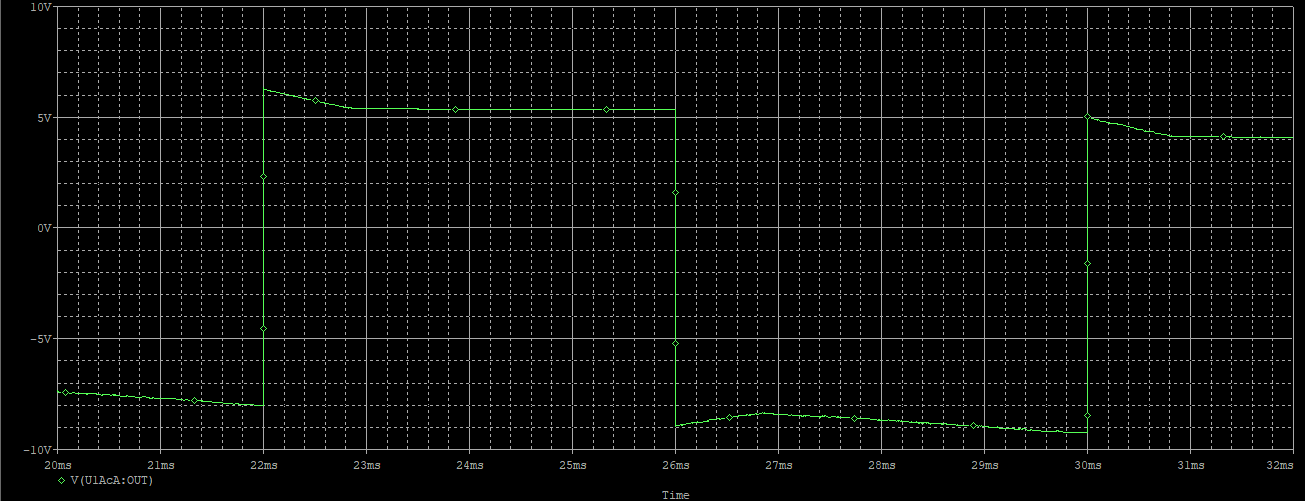
[picture p58: figure]

Figure 59 خرج المصحح (command(

### .7 التطبيق العملي

1 .7. دارة التغذية السالبة والموجبة

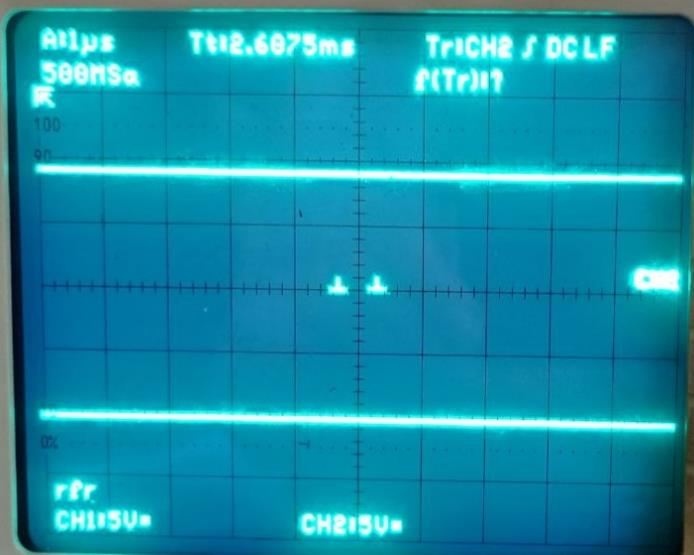
[picture p59: figure]

Figure 60 إشارتي التغذية السالبة والموجبة

نالحظ أن خرج دارة التغذية السالبة مستقر على volt 10 بدون أي تعرجات وكذلك األمر بالنسبة للتغذية الموجبة المستقرة عند volt .9

2 .7. دارة اإلشارة المثلثية

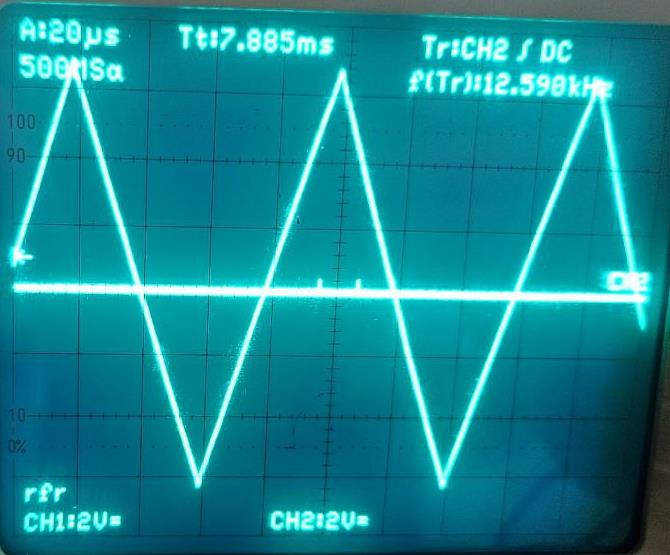
[picture p60: figure]

Figure 61 اإلشارة المثلثية

بالتطبيق العملي حصلنا على إشارة مثلثية بتردد Hk 12.6 = acitcarpF وهو قريب من القيمة
Hk 13 = aciteroeℎ tويعود هذا االختالف إلى االرتياب في قيم العناصر المستخدمة. | النظرية

voltage to frequency | دارة | .7. 3

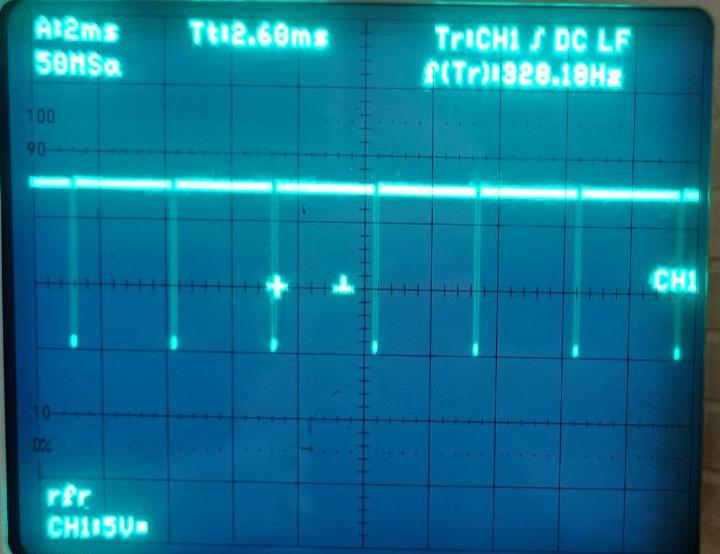
[picture p61: figure]
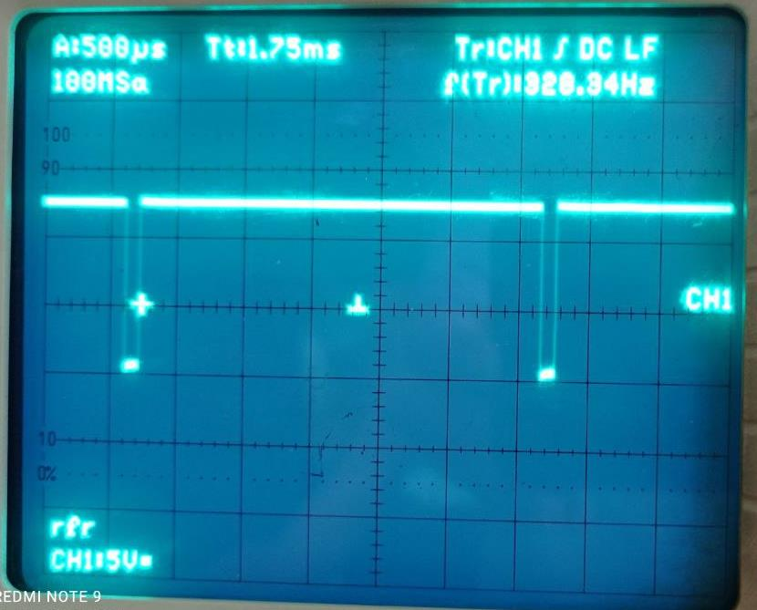
[picture p62: figure]

voltage to frequencyال | إشارة | 62 Figure
نالحظ اختالف بين النتائا العملية وبين نتائا المحاكاة حيث أن مطال اإلشارة غير متناظر بالتالي هذا أدى لتغير صغير بعالقة جهد الدخل بتردد الخرج. لضمان خطية العالقة بين الجهد والتردد تم تجربة عدة قيم لجهد الدخل وقياس التردد الناتا ورسم منحني التردد بداللة الجهد:

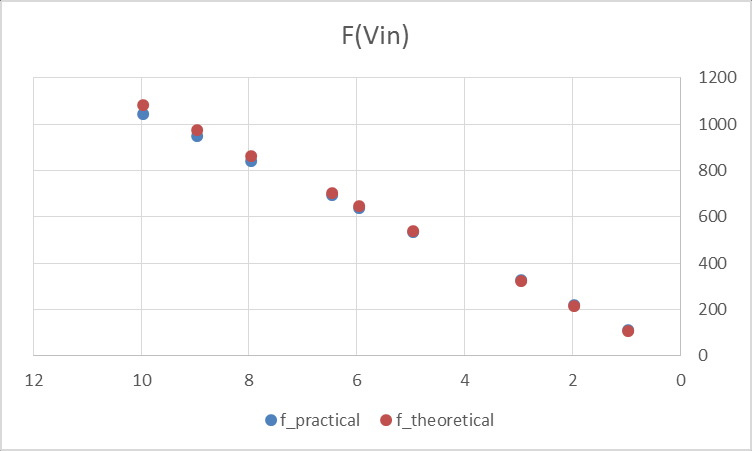
[picture p63: figure]

Figure 63 منحني جهد الدخل بداللة تردد الخرج
نالحظ أن النتائا العملية قريبة جداً من النتائا النظرية وأن العالقة خطية بين جهد الدخل وتردد الخرج عمليا.ً

4 .7. إشارتي القيادة المرجعيتين المترابعتين

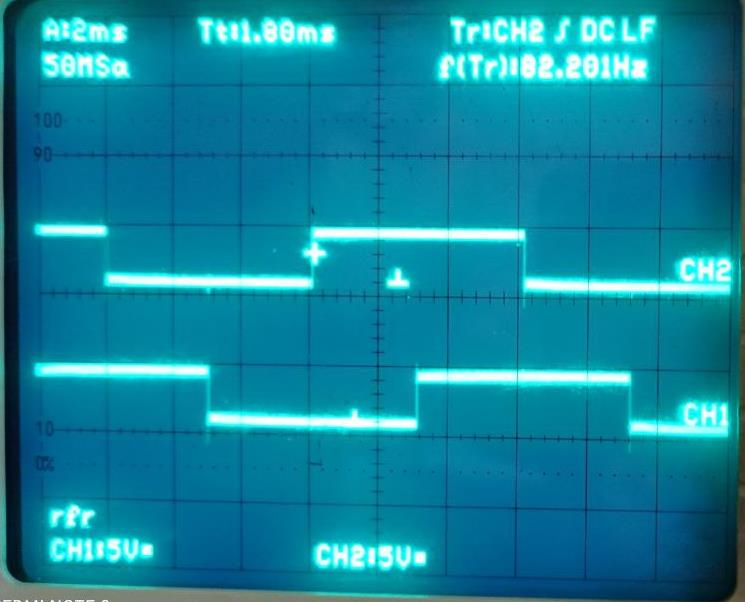
[picture p64: figure]

Figure 64 إشارتي القيادة

عملياً تم توليد إشارات مرجعية مترابعة مطابقة لنتيجة النمذجة والنتائا النظرية.

5 .7. الحلقة المفتوحة
لتدوير المحرك بالحلقة المفتوحة تم مقارنة إشارات القيادة المرجعية مع اإلشارة المثلثية لتوليد نبضات PWM التي تقود جسر H.

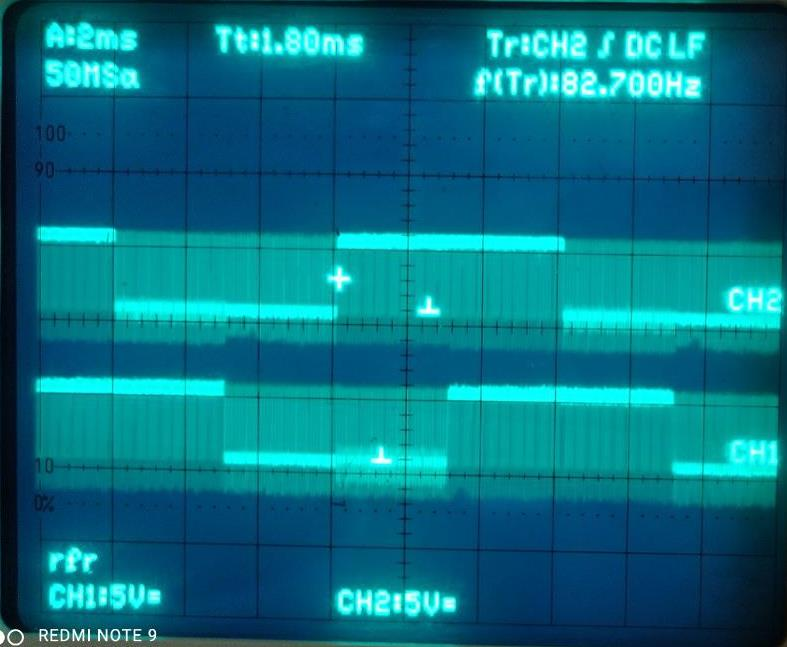
[picture p65: figure]

Figure 65 إشارتي القيادة المحملتان بنبضات PWM

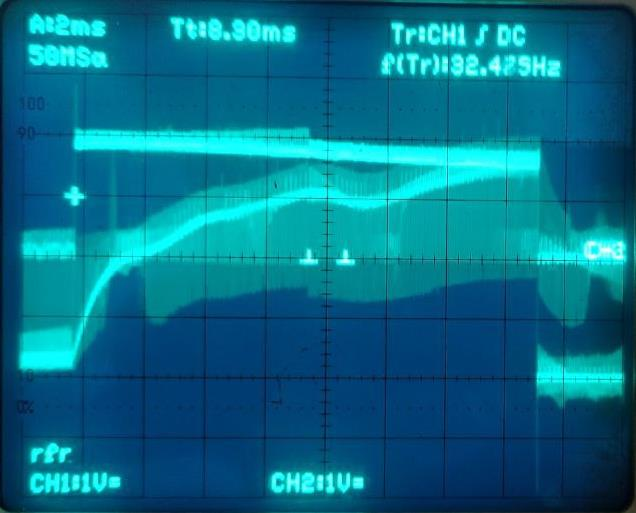
[picture p66: figure]
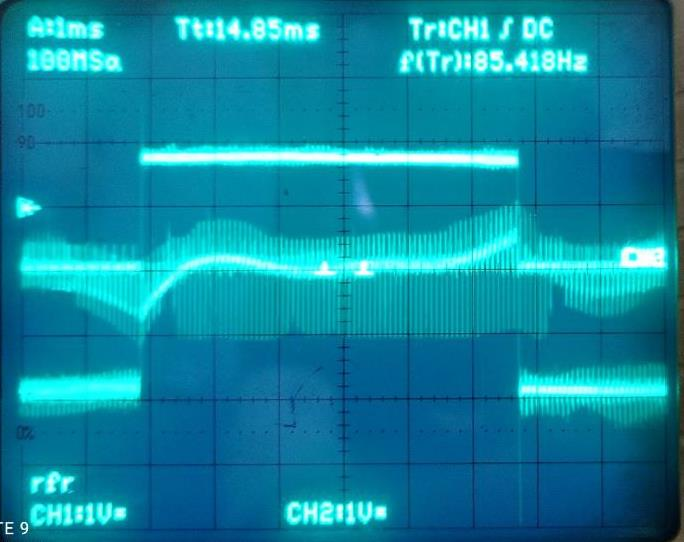
[picture p67: figure]

Figure 67 استجابة التيار من أجل تردد 85 HZ

نالحظ أنه عند إشارة مرجعية بتردد Hz 32.475 فإن التيار يقوم بمالحقة اإلشارة المثلثية باستجابة مقبولة ولكن عند إشارة مرجعية بتردد Hz 85.418 فإن التيار ال يصل إلى القيمة المرجعية مع ذلك فإن المحرك يدور في الحالتين ونستطيع االستفادة من هذه الفكرة بتصميم مصحح عملياً بزمن استجابة أكبر من الزمن المحسوب نظريا.ً

Figure 66 استجابة التيار من أجل تردد 32.4 HZ

6 .7. الحلقة المغلقة:
بتطبيق المصحح عملياً كانت النتائا كما يلي:

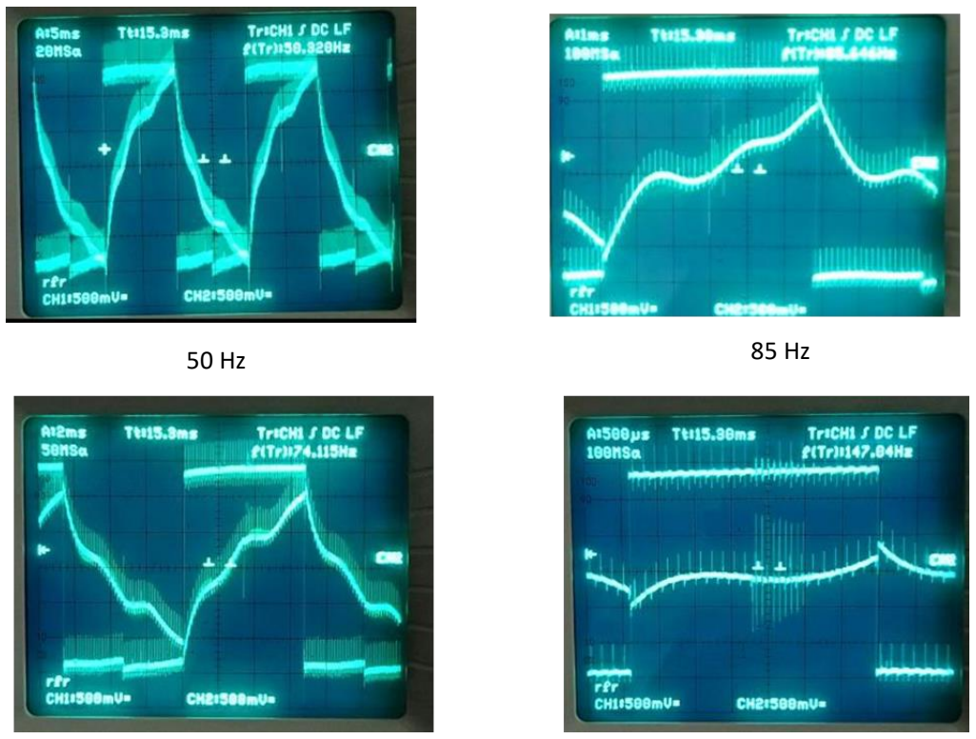
[picture p68: figure]

توضح كل من الصور السابقة مالحقة التيار لإلشارة المرجعية عند ترددات معينة، نالحظ عند زيادة التردد مع ثبات جهد الجسر أن التيار ال يصل للقيمة المرجعية رغم أن المحرك يستمر في الدوران، ذلك ألن دوران المحرك يتم دون وجود حمل ميكانيكي يتطلب عزماً كبيراً بالتالي التيار الذي يستجره كافي للدوران.

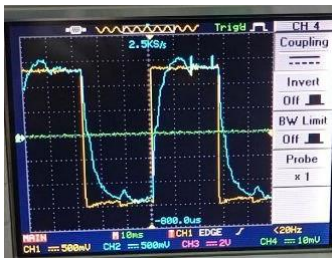
[picture p69: figure]
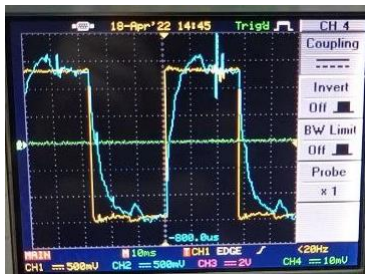
[picture p70: figure]

تم اختبار استجابة التيار كتابع لجهد الجسر عند تردد Hz ،20 فنالحظ أن التيار يستمر في مالحقة اإلشارة المرجعية حتى عند زيادة جهد الجسر بالتالي فنظام الحلقة المغلقة هو نظام صلب )Robust).

استجابة التيار عند جهد جسر volt 24 استجابة التيار عند جهد جسر volt 30

74 Hz | 147 Hz

### الخاتمة

تم في هذا المشروع تصميم وتنفيذ دارة قيادة لمحرك خطوي 801BYGH42 بحيث استطعنا تدويره حتى سرعة 150 RPM بالحلقة المفتوحة. تم بعد التحكم باستجابة التيار باستخدام مصحح PI بالحلقة المغلقة حيث من خالل الدراسة لنموذج المحرك وجدنا أنه ال يمكن الوصول عملياً لزمن استجابة m 0.4 = t، فخفضنا زمن االستجابة حتىm 1.36 = t وهو أفضل زمن استجابة ممكن بإمكانيات المصحح المستخدم.

### مراجع

Sedra,A.S, Smith,K.C.( 1982). Microelectronic Circuits. OXFORD UNIVERSITY PRESS.

https://blog.inventables.com/p/stepper-motors.html

https://www.orientalmotor.com/stepper-motors/technology/everything-about-stepper-motors.html (https://www.orientalmotor.com/stepper-motors/technology/everything-about-stepper-motors.html)
