L0-0na/Motor_Drive/figures/1 lec.jpg

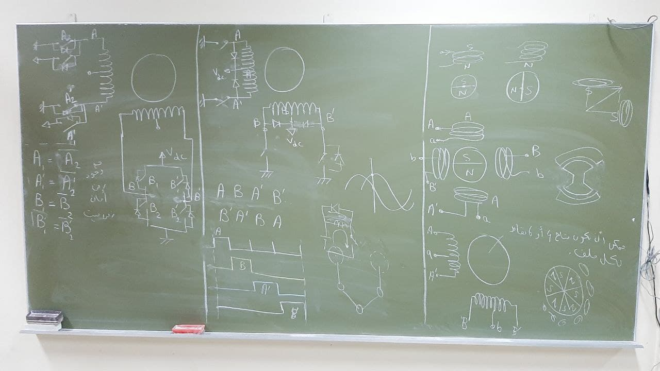
figures/1 lec.jpg
