L0-0na/Motor_Drive/figures/1ms.png

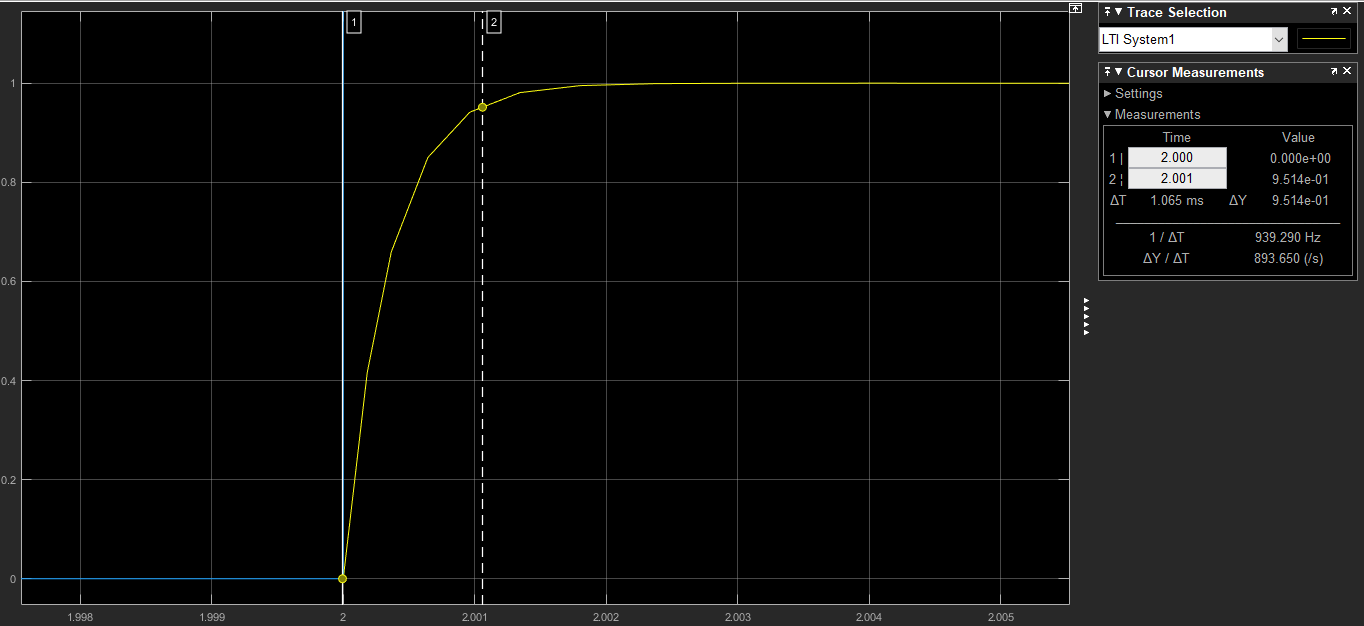
figures/1ms.png
