L0-0na/Motor_Drive/figures/2 lec.jpg

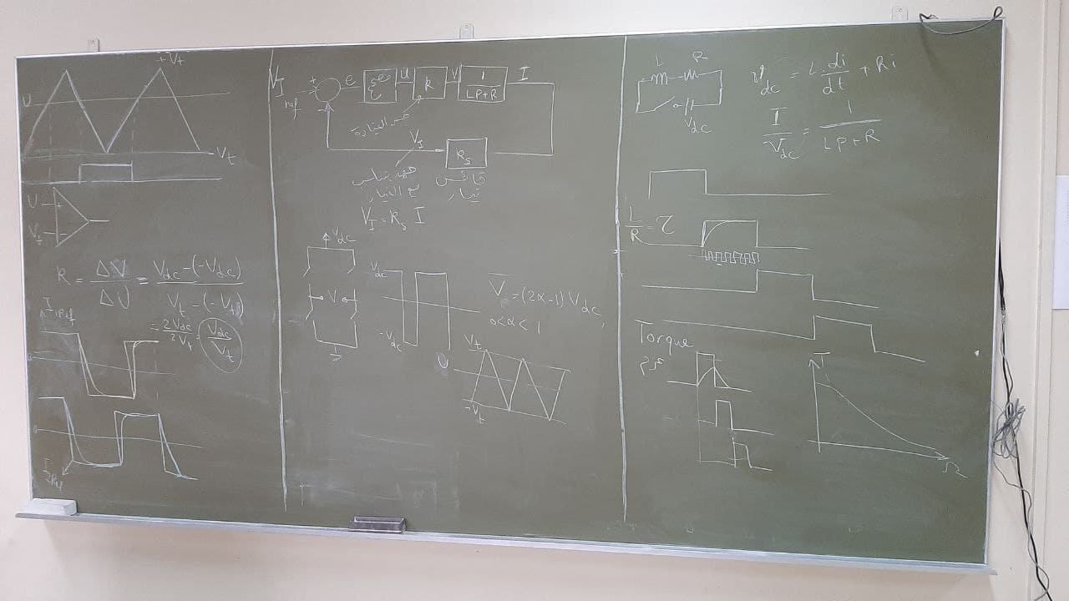
figures/2 lec.jpg
