L0-0na/Motor_Drive/figures/3 lec.jpg

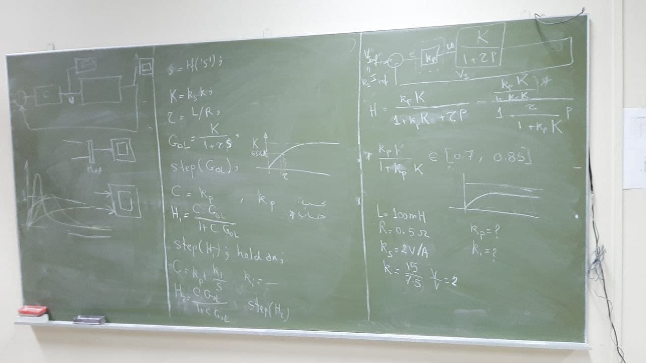
figures/3 lec.jpg
