L0-0na/Motor_Drive/figures/index.png

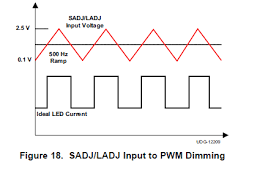
figures/index.png
