L0-0na/Motor_Drive/figures/Screenshot 2022-02-14 180736.png

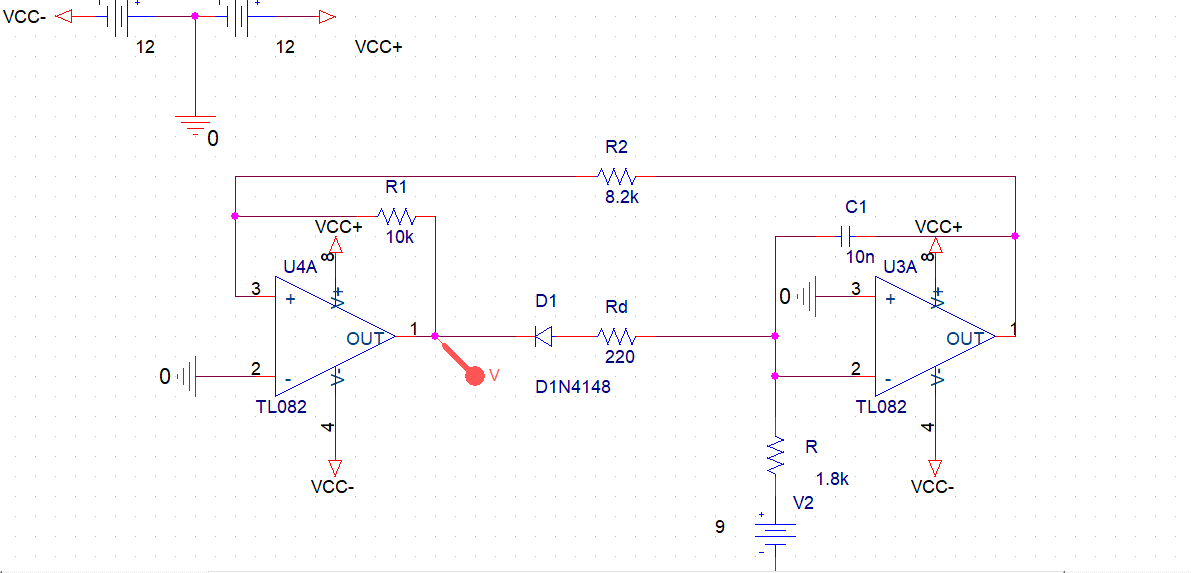
figures/Screenshot 2022-02-14 180736.png
