L0-0na/Motor_Drive/figures/wavgen.png

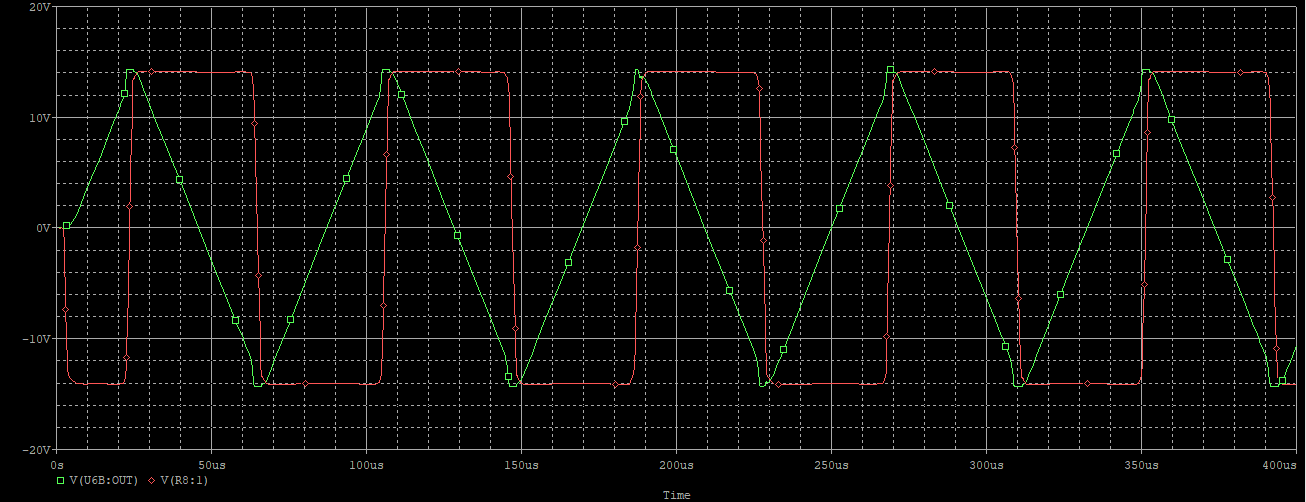
figures/wavgen.png
