L0-0na/Motor_Drive/figures/currentmeasure2.png

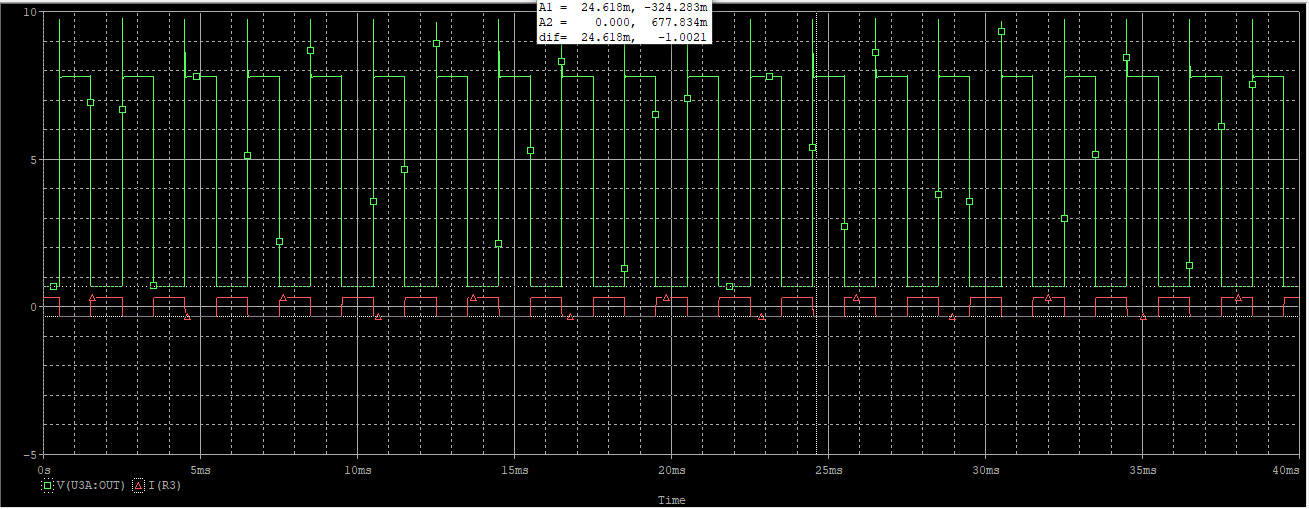
figures/currentmeasure2.png
