L0-0na/Motor_Drive/figures/currentmeasure.png

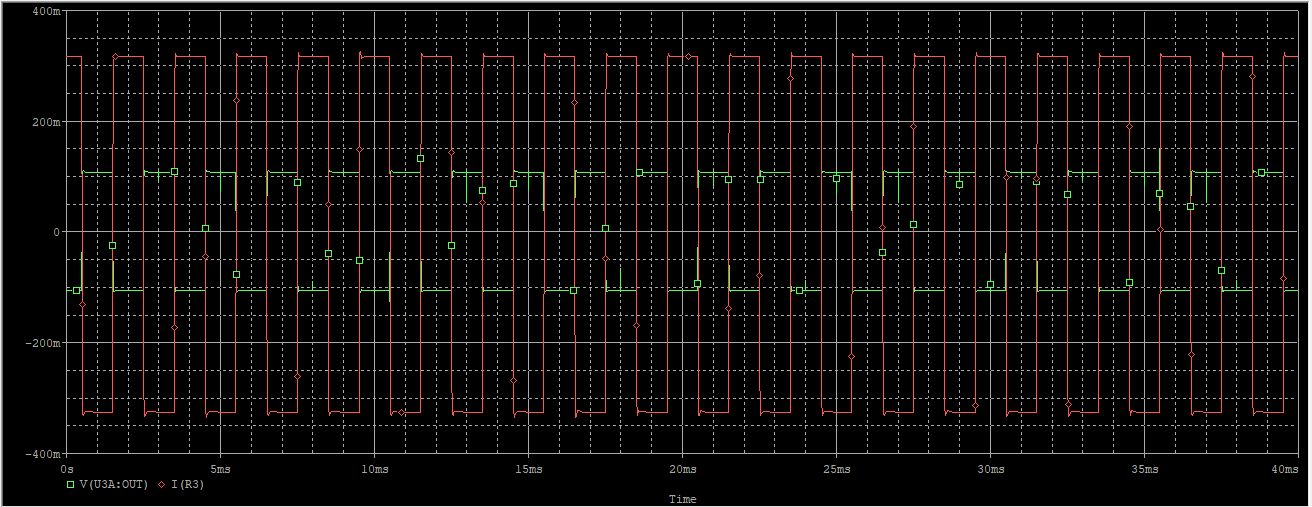
figures/currentmeasure.png
