L0-0na/Motor_Drive/(list of files, drawings)

Other design files:
clippers/CLIPPERS.DSN
clippers/clippers.opj
Pspice/H_BRIDGE.DSN
Pspice/H_bridge.opj
Pspice/HB_DRIVER.DSN
Pspice/HB_driver.opj
Pspice/TRGEN.DSN
Pspice/trgen.opj
